LiWenhui2/RC-Car/cadence/controller/schematic/README.md

# 手持遥控器原理图

存放手持遥控器板的 OrCAD Capture 工程与原理图，主要包括 `.opj` 和 `.dsn` 文件。

内容覆盖 ESP32-C3、双轴摇杆、按键、状态指示、I2C 显示接口、USB及遥控器电源。
