LiWenhui2/RC-Car/cadence/vehicle/schematic/README.md

# 车辆控制板原理图

存放车辆控制板的 OrCAD Capture 工程与原理图，主要包括 `.opj` 和 `.dsn` 文件。

内容覆盖电池输入与保护、电源分配、ESP32-C3 SuperMini、TB6612FNG、电机接口、舵机接口及调试接口。
