LiWenhui2/RC-Car/cadence/controller/pcb/README.md

# 手持遥控器 PCB

存放手持遥控器板的 PCB 设计文件，主要文件类型为 `.brd`。

此处保留板框、布局、布线、约束和覆铜等可编辑设计；生产输出统一放入项目根目录的 `manufacturing`。
