LiWenhui2/RC-Car/cadence/vehicle/pcb/README.md

# 车辆控制板 PCB

存放车辆控制板的 PCB 设计文件，主要文件类型为 `.brd`。

此处保留板框、层叠、布局、布线、约束和覆铜等可编辑设计；Gerber 等生产文件应输出到项目根目录的 `manufacturing`。
