LiWenhui2/RC-Car/software/arduino/controller/README.md

# 遥控器正式固件

这里将保存 A 板的正式遥控器工程。接口保持输出标准化的 `throttle`、`steering`、`buttons` 和 `sequence`。
