LiWenhui2/RC-Car/agent.md

# RC-CAR 项目固定约束

本文件用于保存项目中已经确认的架构决定。后续建议、采购清单、PCB、机械结构和软件设计必须以本文件为准；除非用户明确修改，不得自行恢复为旧方案。

## 1. 当前版本决定

- 项目版本：`RC-CAR-V1.0`。
- 第一版车辆必须使用**舵机转向**，不使用左右轮差速完成转向。
- 第一版推荐机械结构：前轮转向机构 + 1 个 MG90S 舵机 + 后轮双电机驱动。
- 第一版油门命令同时作用于后左、后右电机；转向命令只转换为舵机角度。
- 第一版已验证 ESP-NOW、摇杆比例控制、100ms 失联停车和上电回中锁定；油门由摇杆直接控制，按键作为急停并触发重新回中解锁。车辆端采用加速每包80、减速每包200的油门斜坡，以及每10ms最多6μs的舵机平滑更新。
- 实车验证两只后轮电机的安装极性均与逻辑前进方向相反；车辆执行层固定使用 `MOTOR_A_DIRECTION=-1`、`MOTOR_B_DIRECTION=-1` 修正，通信层仍保持正油门代表前进。
- 第一版失联时：电机 PWM 清零、TB6612 STBY 拉低、舵机回中或保持已验证的安全中位。

## 2. 四轮差速扩展目标

- 后续版本允许改装为四个固定驱动轮的四轮差速结构。
- 扩展模式下，同一侧前后电机共用方向和 PWM 命令：
  - `left = throttle + steering`
  - `right = throttle - steering`
- 不要求四个车轮独立闭环控制；只要求左侧一组、右侧一组。
- 第一版购买的固定四TT电机4WD底盘不能直接作为舵机转向底盘；除非更换前桥机构，否则不得把它列为V1必买件。

## 3. 机械与安装孔预留

- V1底盘必须具有四个车轮、前轮转向节/拉杆和舵机安装位；后轮使用两个低电流TT减速电机或等效减速电机。
- 优先选择可拆卸前转向总成的底盘，使未来能换成固定前电机支架。
- 车体控制板目标外形不超过 `80mm × 60mm`。
- 控制板预留4个M3安装孔，建议孔径3.2mm、孔中心距约72mm × 52mm；最终尺寸必须在选定底盘实测后冻结。
- 底盘或转接板保留10mm孔距的M3孔阵列，并在前后各保留一组3.2mm宽长槽，便于在舵机前桥和固定电机支架之间改装。
- PCB天线端朝车体外侧，前方和下方保持净空，不得被电池、电机或金属铜柱遮挡。

## 4. 车体PCB固定接口

- 主控：ESP32-C3；原型阶段使用已经购买的 SuperMini 开发板，正式PCB使用ESP32-C3-MINI-1或预留SuperMini插座。
- 舵机接口：1个标准3针接口，定义为 `GND / SERVO_5V / SERVO_PWM`。
- 电机驱动：预留两组TB6612FNG模块插座或两颗驱动芯片位置：
  - Driver A：V1装配，控制后左、后右电机。
  - Driver B：V1可不装，未来控制前左、前右电机。
- 四个电机接口必须全部预留：`M_REAR_L`、`M_REAR_R`、`M_FRONT_L`、`M_FRONT_R`。
- Driver A与Driver B默认共享左右两组逻辑网络，使未来四轮差速不必增加大量GPIO：
  - `LEFT_IN1 / LEFT_IN2 / LEFT_PWM`
  - `RIGHT_IN1 / RIGHT_IN2 / RIGHT_PWM`
  - `MOTOR_STBY`
- 预留 `BAT_ADC`、I2C显示接口、BOOT/RESET、UART测试点和电源测试点。
- 在确认SuperMini实际引脚、启动绑带和USB占用之前，只冻结逻辑网络名，不提前冻结GPIO号码。

### 4.1 已选 ESP32-C3 开发板实物版本

- 遥控器板和车辆板当前选用同款 **DZQJ ESP32-C3 Mini/SuperMini 开发板**，不是裸 ESP32-C3-MINI-1 模组。
- 商品资料标注主芯片为 `ESP32-C3FN4`，板载 `4 MB Flash`，开发板标称外形为 `22.52 mm × 18 mm`。
- 开发板带 USB-C 接口、`BOOT` 按键和 `RESET` 按键；商品图显示左右各一排共两排引脚，计划在正式PCB上采用排针/排母插接方式，便于更换和调试。
- 当前实物的两排公排针已经整理并焊接为向下插接形式，可以直接插入标准面包板和2.54mm洞洞板。正式PCB应使用与之配套的两排通孔排母，不再把开发板本体直接焊死在主板上。
- 实物确认左右两排各有8根公排针，单排相邻引脚节距为2.54mm。插入2.54mm洞洞板后，左右两排针所在孔位连同两端自身共占7个孔位：两端之间有5个空孔，但7个孔中心形成6段间隔，因此两排中心距为 `6 × 2.54 mm = 15.24 mm`（600 mil）。
- 商品资料标注板载蓝色LED连接 `GPIO8`。设计时必须把它视为已有板载负载，不得默认GPIO8完全空闲。
- 商品说明称支持从外部 `5V` 与 `GND` 引脚供电，并明确提示外部供电与USB供电不可同时使用。车辆板必须避免USB 5V与外部5V电源硬并联。
- 进入下载模式时，商品说明给出的操作为：按住 `BOOT`，按下并松开 `RESET`，再松开 `BOOT`；必要时重复。
- 商品资料声称开发板支持3.3～6V供电，但本项目不依赖该宽范围宣传参数；车辆端仍按已验证的稳定5V输入方案设计，并核对实物板载稳压和5V引脚连接。
- PCB封装暂定名为 `ESP32_C3_DZQJ_SUPERMINI_SOCKET`，原理图符号暂定名为 `ESP32_C3_DZQJ_SUPERMINI`。
- 已确认每排8针、单排相邻引脚节距为2.54mm、两排中心距为15.24mm。开始制作 `.pad/.dra/.psm` 前，仍需核对并记录：方针尺寸、板边至首末孔中心距离、USB-C突出量、天线实际区域及装配总高度。
- 封装方向统一按元器件面顶视图描述，并在封装与符号对照表中明确USB端、天线端、左右两排每个焊盘的编号和实际丝印名称；不得仅凭网络上的其他SuperMini引脚图套用。

## 5. 电源固定规则

- 车体默认使用4节AA镍氢电池，标称约4.8V；不得将USB 5V与电池直接硬并联。
- 电源划分为：`VBAT_MOTOR`、`SERVO_5V`、`3V3_LOGIC`，三者共地但分支布线。
- 电机VM从电池经保险丝和反接保护供电。
- 当前V1已验证MG995可由4节AA镍氢电池的大电流分支直接供电；不得从ESP32的3.3V或5V脚给舵机供电。正式PCB仍需独立舵机电源分支和至少2A瞬态能力。
- ESP32逻辑使用独立3.3V稳压支路。
- 驱动入口预留470～1000µF电解电容；舵机5V入口预留1000µF电解电容；每个电机端子直接并联100nF陶瓷电容。
- 未来四电机扩展前必须实测单个电机的空载、启动和堵转电流，并重新核算电池、开关、线宽、连接器和驱动器余量。

## 5.1 遥控器PCB固定接口

- 遥控器板使用第二块ESP32-C3，连接双轴摇杆的两路ADC和按键输入。
- 预留0.96英寸I2C显示屏接口、状态LED、至少2个功能按键、BOOT/RESET和USB-C。
- 遥控器数据包只发送标准化的`throttle`与`steering`，不因车体采用舵机转向或四轮差速而更改硬件接口。
- 遥控器可先用USB供电；脱线运行时使用4节AAA镍氢电池和独立3.3V稳压，不得把电池与USB直接硬并联。

## 6. 软件架构固定规则

- 无线数据包和上层控制量不得绑定具体底盘结构；统一保留 `throttle`、`steering`、`buttons`、`sequence`。
- 执行层必须通过统一接口实现两种策略：
  - `ServoSteeringDrive`：两个后轮同速，`steering`映射为舵机角度。
  - `Differential4WD`：`steering`参与左右轮差速计算。
- 通过配置项选择 `SERVO_STEERING` 或 `DIFFERENTIAL_4WD`，通信层、失联保护和摇杆校准代码保持共用。
- 电机控制、舵机控制、无线通信、电池检测和安全状态机必须分模块实现。

## 7. 当前采购与验证状态

- 已购买并验证：ESP32-C3 SuperMini开发板×2、TB6612FNG、PS2双轴摇杆、四轮舵机转向底盘、MG995、4节AA镍氢电池及电池盒、面包板、导线和抗干扰电容。
- 已验证：两板ESP-NOW通信、100ms失联保护、双后轮正反转、MG995供电与脉宽控制。
- V1不应购买固定四TT电机的4WD差速底盘；应购买带前轮舵机转向机构的四轮底盘。
- V1最低需要1块TB6612FNG；PCB和线束必须为第2块TB6612FNG及前轮电机预留位置。

## 8. 建议的下一批材料

1. 四轮舵机转向底盘：前轮转向节/拉杆、后轮双电机、四个车轮、安装件。
2. MG995舵机×1（已购买并完成校准）。
3. TB6612FNG已焊排针模块×1；预算允许可一次购买2块，第二块用于扩展和备件。
4. PS2双轴10kΩ摇杆模块×1。
5. 4节AA电池盒、AA镍氢电池×4、对应充电器。
6. 5V/至少2A升降压模块×1，用于舵机支路；逻辑支路使用可靠3.3V稳压。
7. 100nF陶瓷电容至少4只、470～1000µF电解电容至少2只。
8. 电源开关、保险丝/自恢复保险丝、反接保护、22AWG电机线、连接器和热缩管。
