LiWenhui2/RC-Car/docs/RC-Car-V1_6x8洞洞板施工坐标表.md

# RC-Car V1 6×8cm洞洞板施工坐标表

板规格：80mm×60mm，2.54mm孔距，按31列×23行设计。列号从元件面左到右为1～31，行号从上到下为1～23。

## 元件坐标

| 器件 | 孔坐标/占用区 |
|---|---|
| JBAT 2P | (2,3)=GND；(4,3)=VBAT+ |
| 5V模块安装区 | 列14～30、行1～6；JREG位于(14,7)/(16,7)/(18,7)/(20,7) |
| ESP32-C3排母 | 左排列6、右排列12；行9～16，共2×8 |
| TB6612排母 | 左排列17、右排列23；行9～16，共2×8 |
| C1 1000μF | (25,9)=正；(25,11)=负 |
| C2 1000μF | (4,18)=正；(2,18)=负 |
| 后左电机端子 | (28,12)/(30,12) |
| 后右电机端子 | (28,16)/(30,16) |
| 舵机3P端子 | (2,21)=GND；(4,21)=VBAT；(6,21)=SIG |

## 为减少飞线采用的新车辆GPIO

| ESP32 | TB6612/舵机 |
|---|---|
| GPIO10 | PWMA |
| GPIO4 | AIN2 |
| GPIO3 | AIN1 |
| GPIO7 | STBY |
| GPIO6 | BIN1 |
| GPIO5 | BIN2 |
| GPIO20 | PWMB |
| GPIO21 | MG995信号 |

该映射与之前面包板程序不同。洞洞板焊好后必须使用配套的优化引脚程序，不能继续使用旧车辆端固件。

## 最少跳线

- 同排短直连4条：GPIO10-PWMA、GPIO7-STBY、GPIO6-BIN1、GPIO5-BIN2。
- 必要绝缘信号线4条：GPIO4-AIN2、GPIO3-AIN1、GPIO20-PWMB、GPIO21-SERVO。
- VBAT和GND各1条20AWG母线；电机输出使用20～22AWG短线。
- 100nF电容C3/C4直接焊在两只TT电机端子，不占洞洞板孔位。
