LiWenhui2/RC-Car/software/arduino/shared/README.md

# 公共协议与配置

这里将保存两端共享的通信数据结构、无线信道、失联保护参数和硬件无关控制接口。
