LiWenhui2/RC-Car/software/arduino/vehicle/README.md

# 车体正式固件

这里将保存 B 板的正式车体工程。V1 使用舵机转向和后轮双电机驱动，并保留四轮差速策略扩展。
