LiWenhui2/RC-Car/docs/diagrams/RC-Car-V1_6x8_真实元件面.png

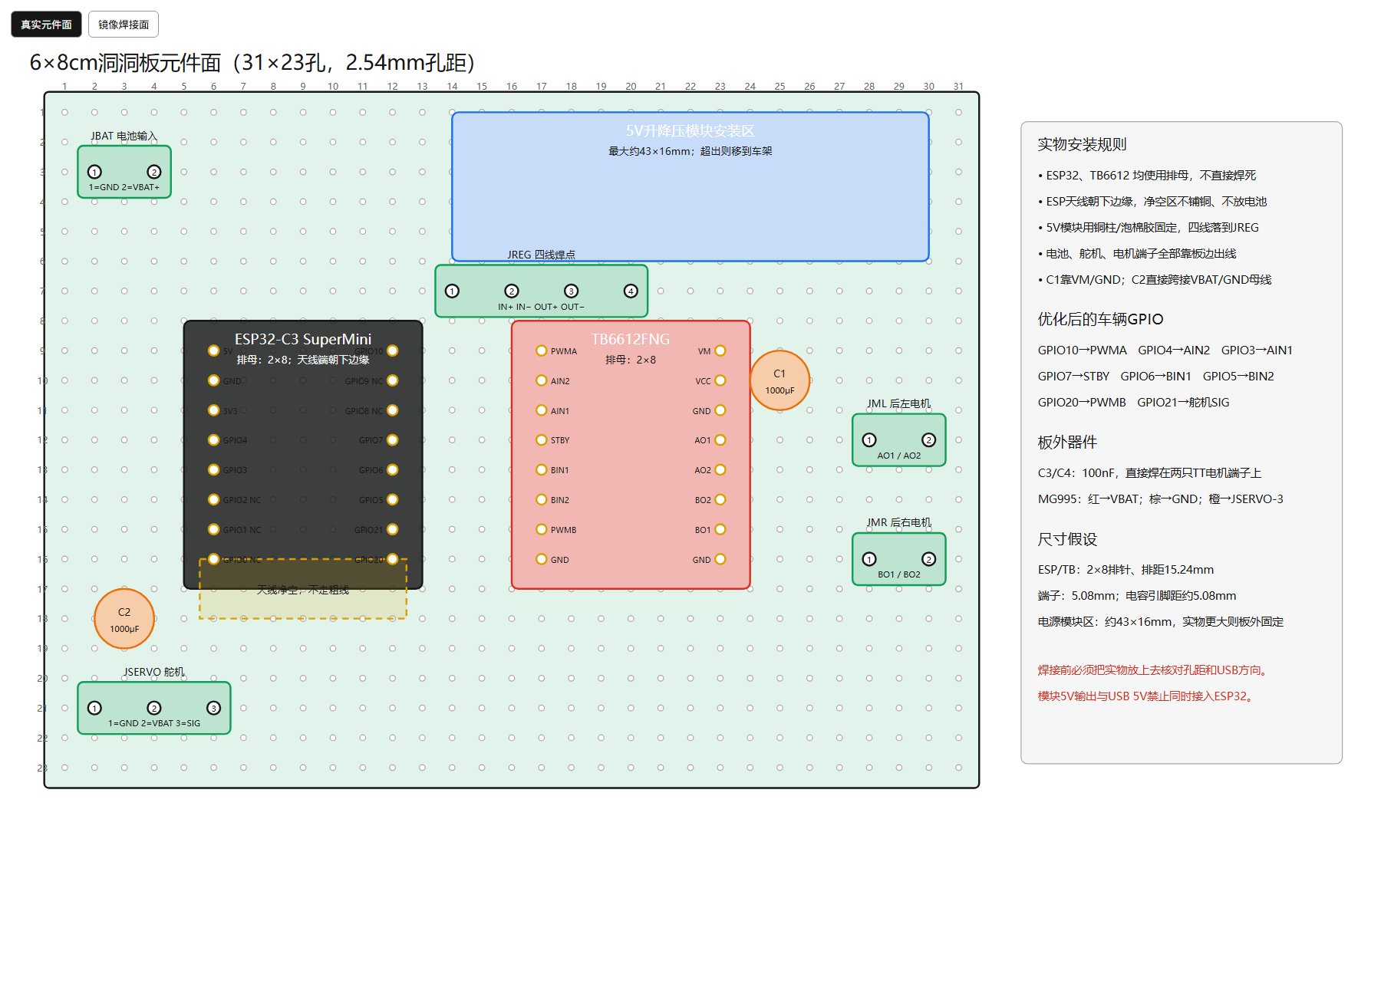
docs/diagrams/RC-Car-V1_6x8_真实元件面.png
