LiWenhui2/RC-Car/docs/diagrams/RC-Car-V1_6x8_镜像焊接面.png

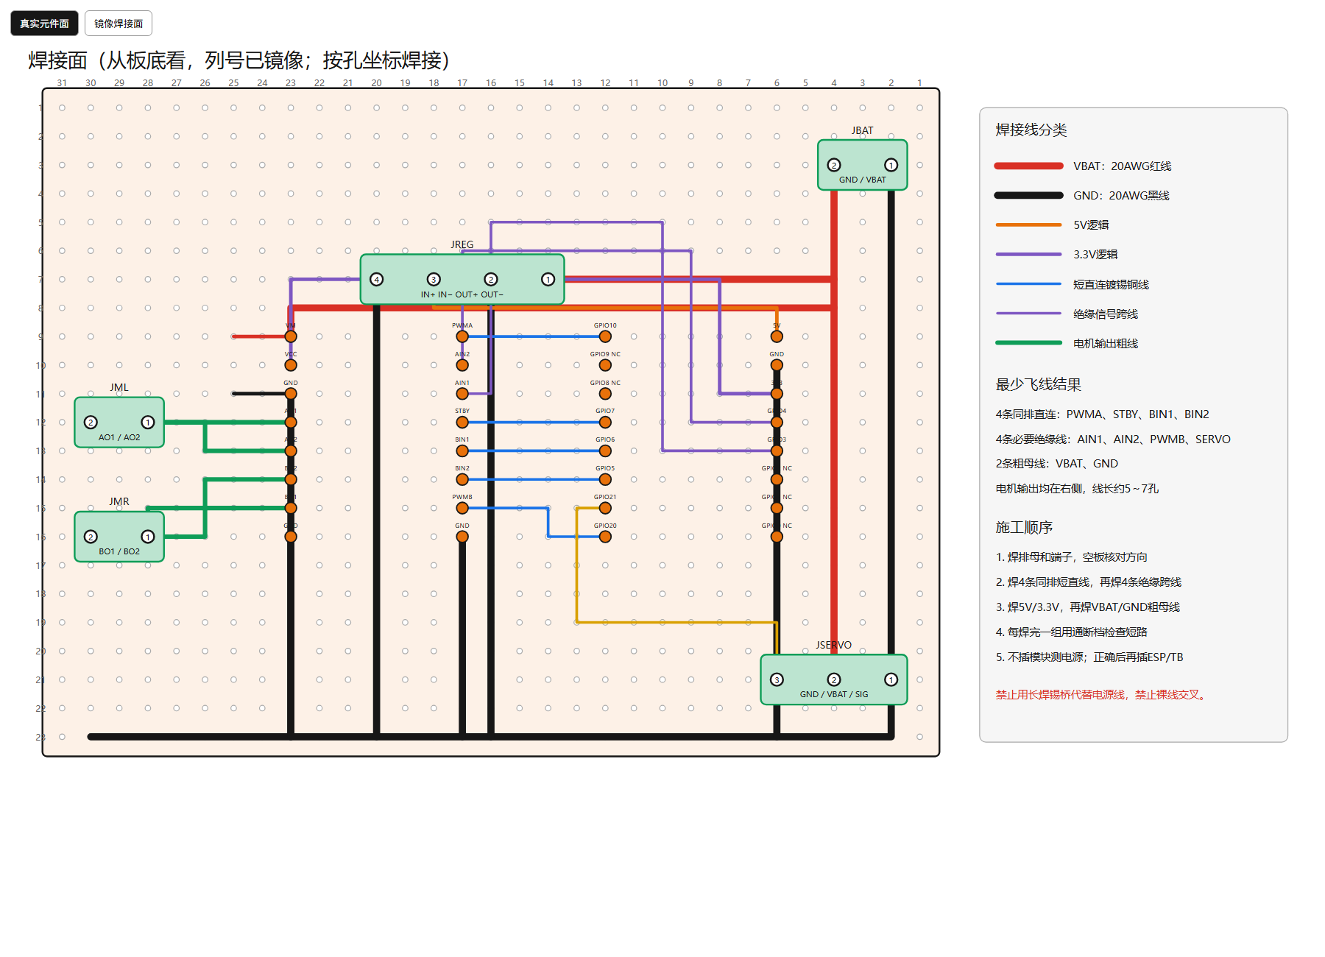
docs/diagrams/RC-Car-V1_6x8_镜像焊接面.png
