LiWenhui2/RC-Car/docs/diagrams/RC-Car-V1_洞洞板元件面.png

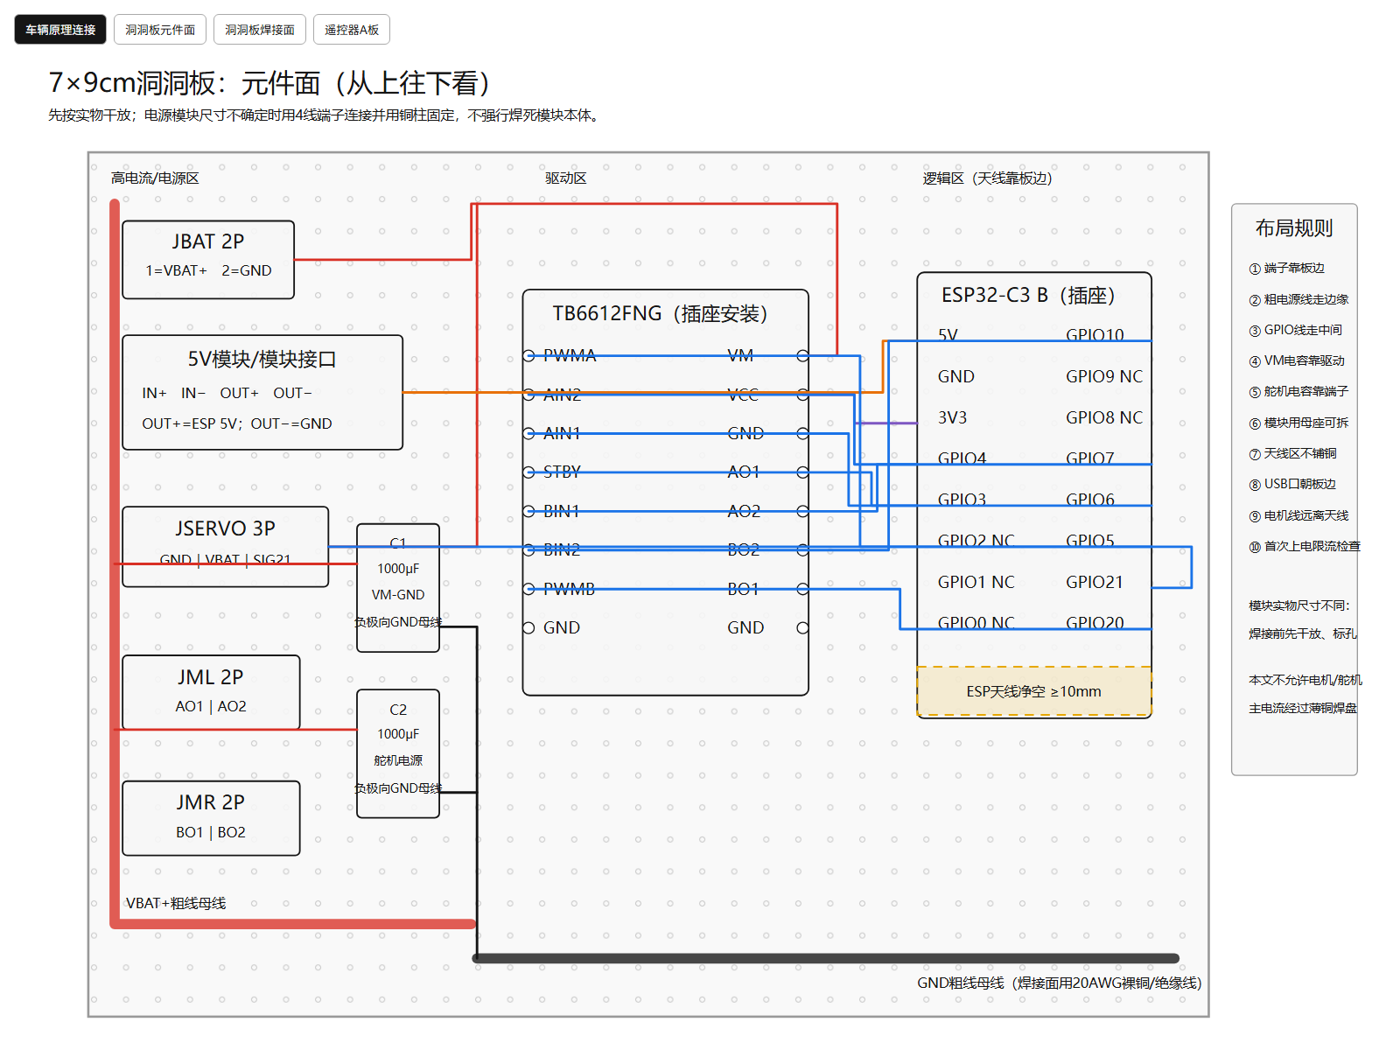
docs/diagrams/RC-Car-V1_洞洞板元件面.png
