LiWenhui2/RC-Car/docs/diagrams/RC-Car-V1_洞洞板焊接面.png

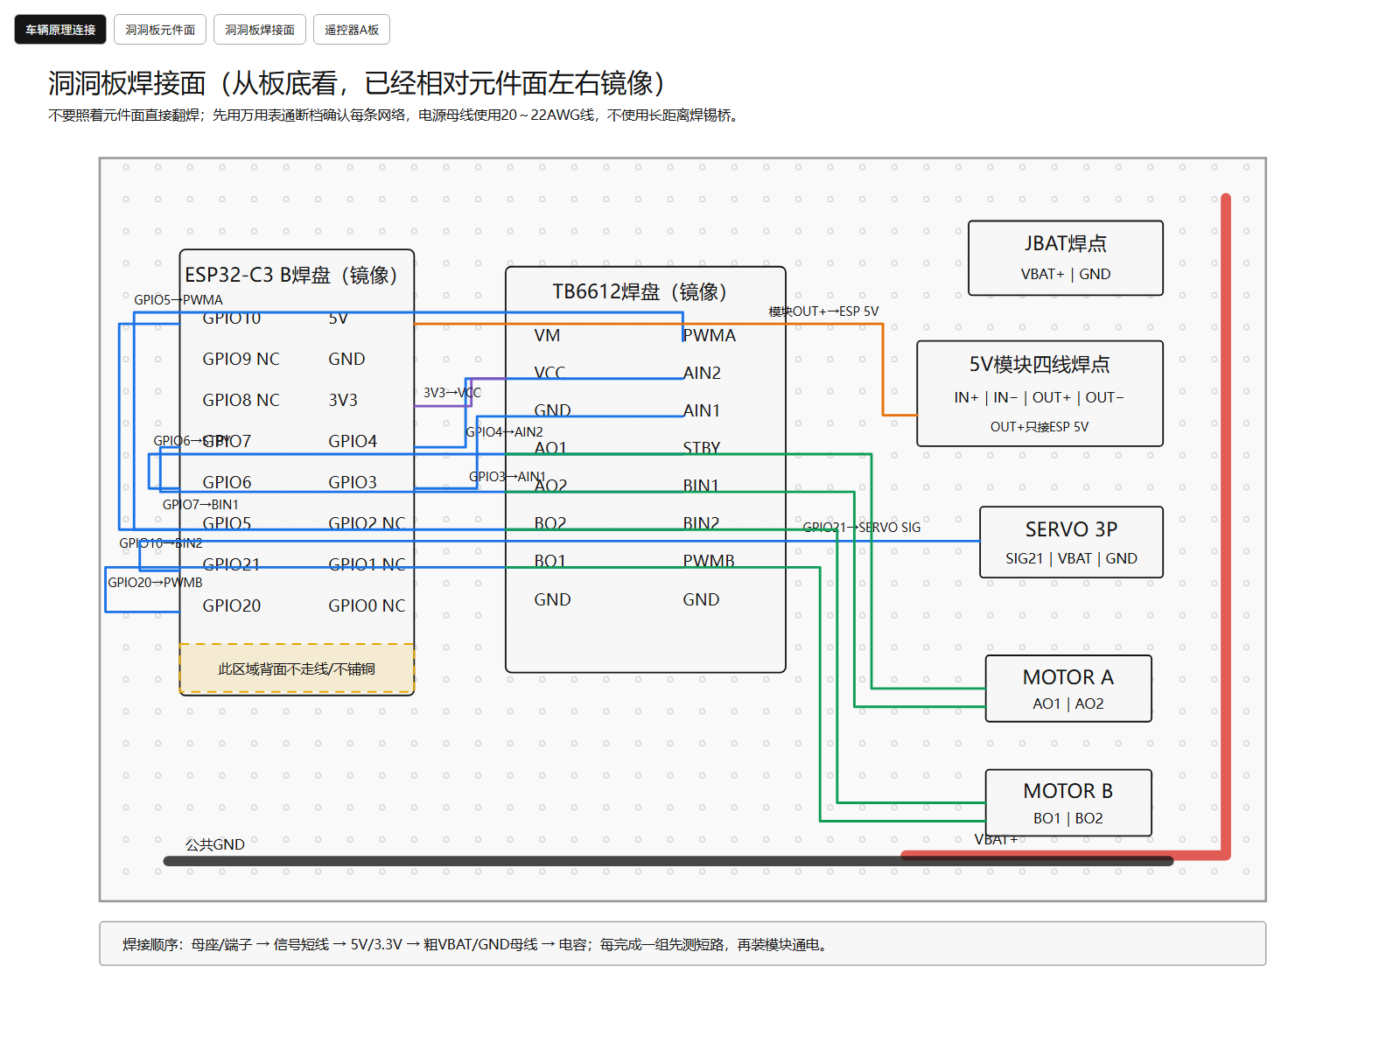
docs/diagrams/RC-Car-V1_洞洞板焊接面.png
