LiWenhui2/RC-Car/docs/diagrams/RC-Car-V1_车辆原理连接.png

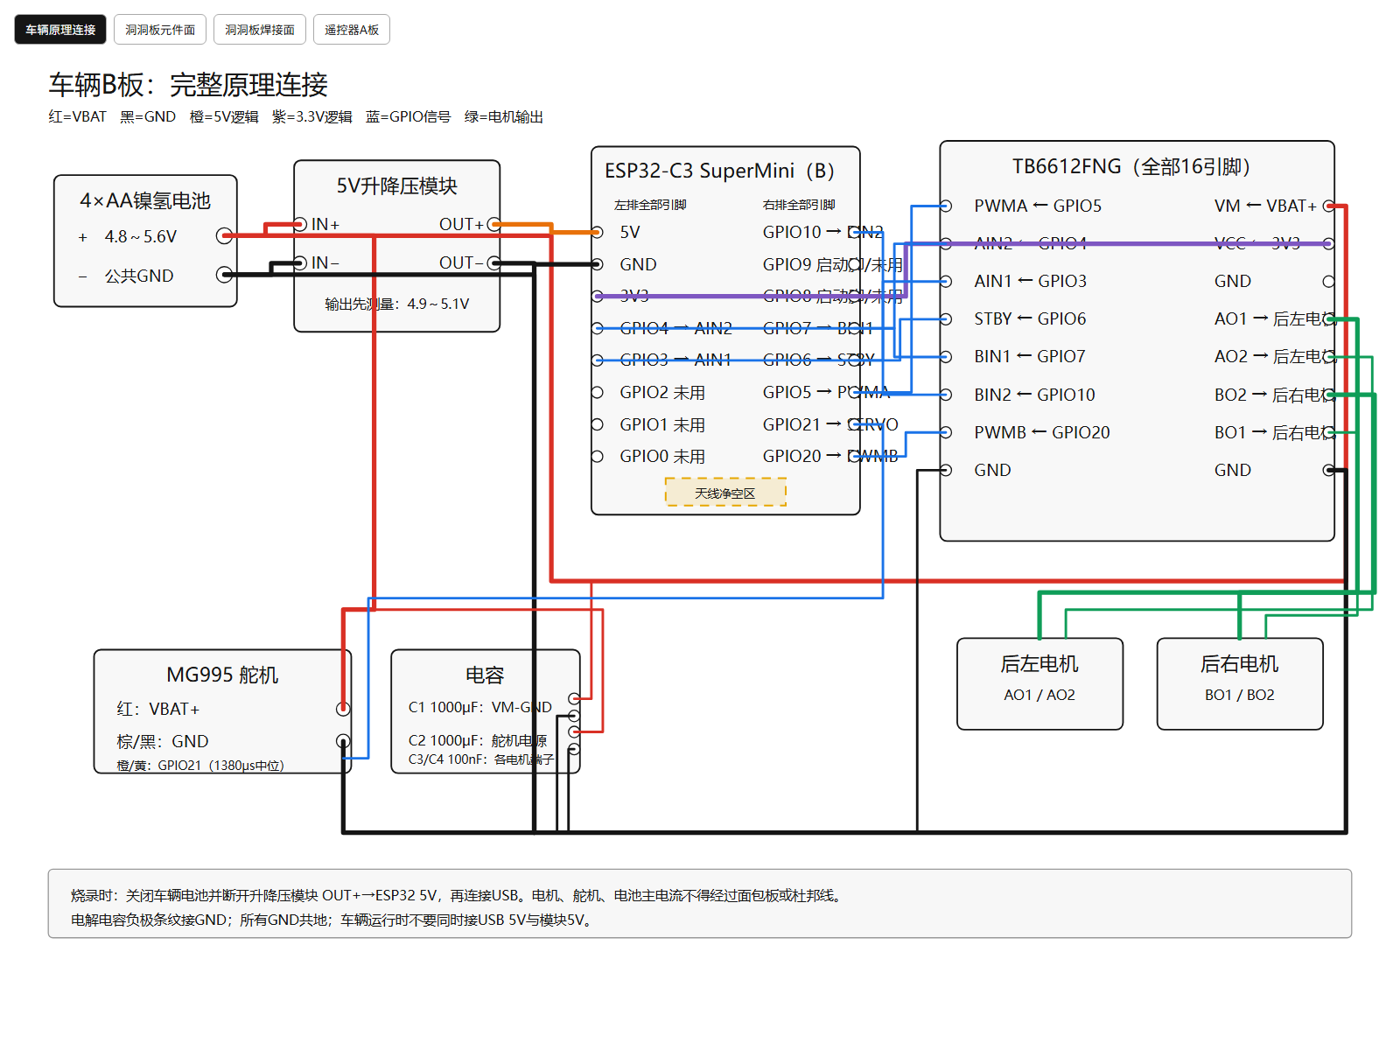
docs/diagrams/RC-Car-V1_车辆原理连接.png
