LiWenhui2/RC-Car/docs/diagrams/RC-Car-V1_遥控器接线.png

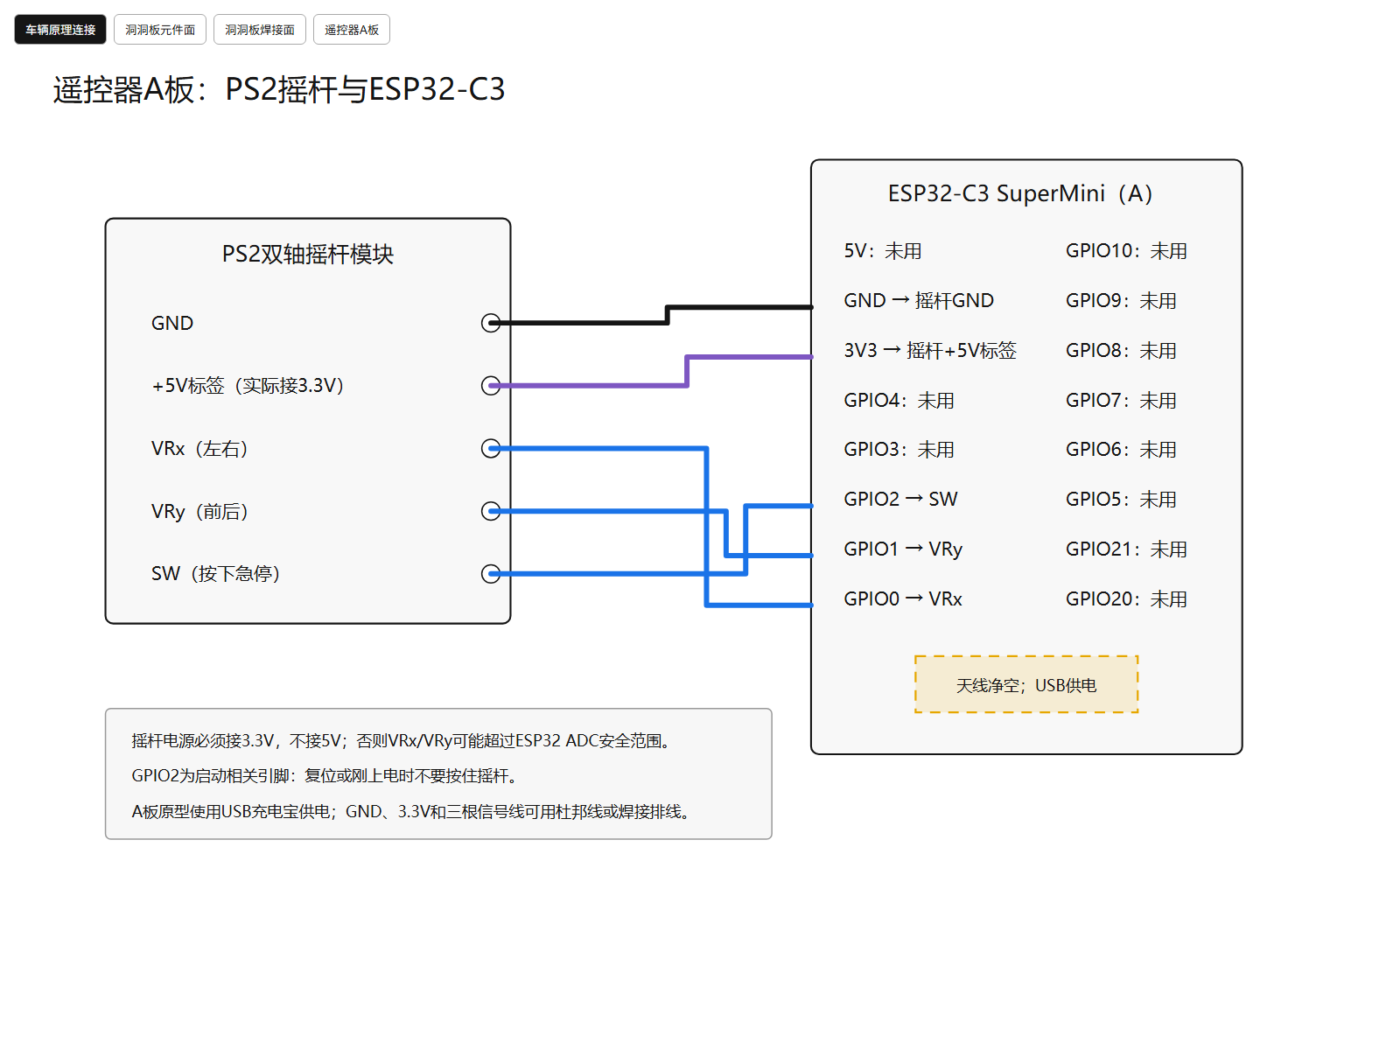
docs/diagrams/RC-Car-V1_遥控器接线.png
