LiWenhui2/RC-Car/outputs/01a0d97b-3272-7c23-ab1a-42ca7874a5cd/preview.png

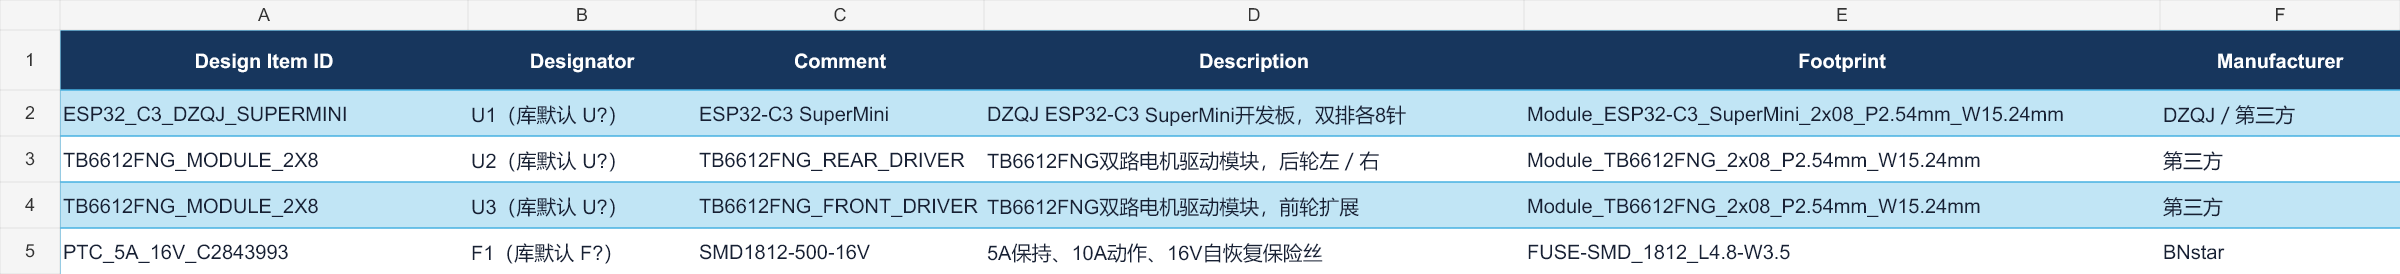
outputs/01a0d97b-3272-7c23-ab1a-42ca7874a5cd/preview.png
