LiWenhui2/RC-Car/outputs/ble-control/phone-launch.png

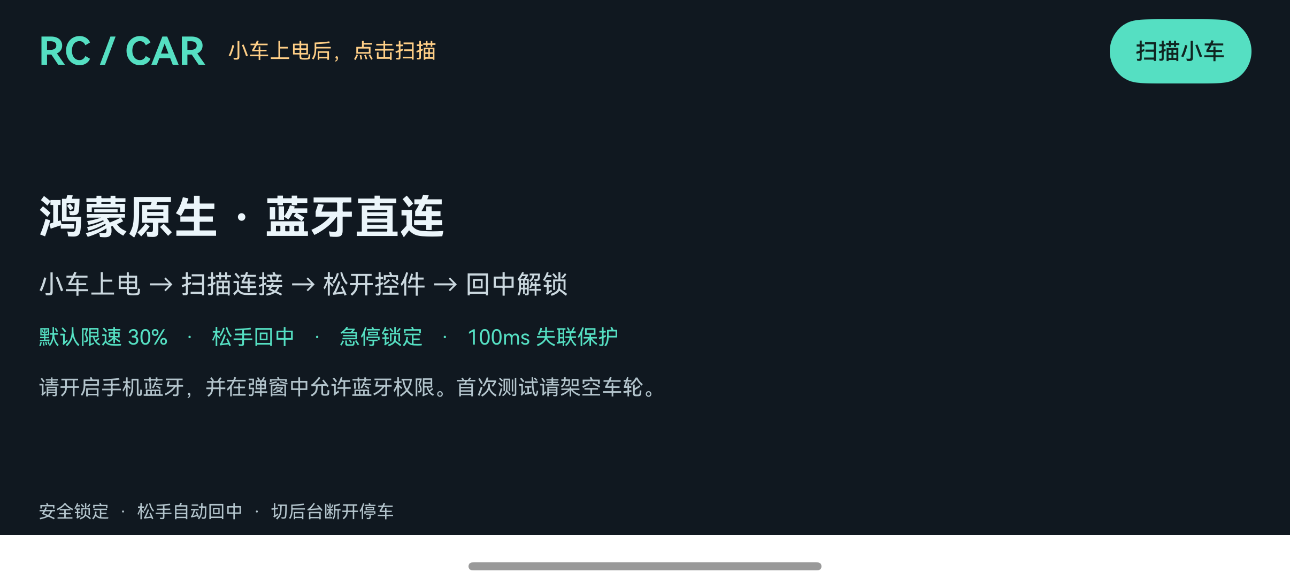
outputs/ble-control/phone-launch.png
