LiWenhui2/RC-Car/outputs/cadence_production_sop_20260921/render5/contacts/contact-01.jpg

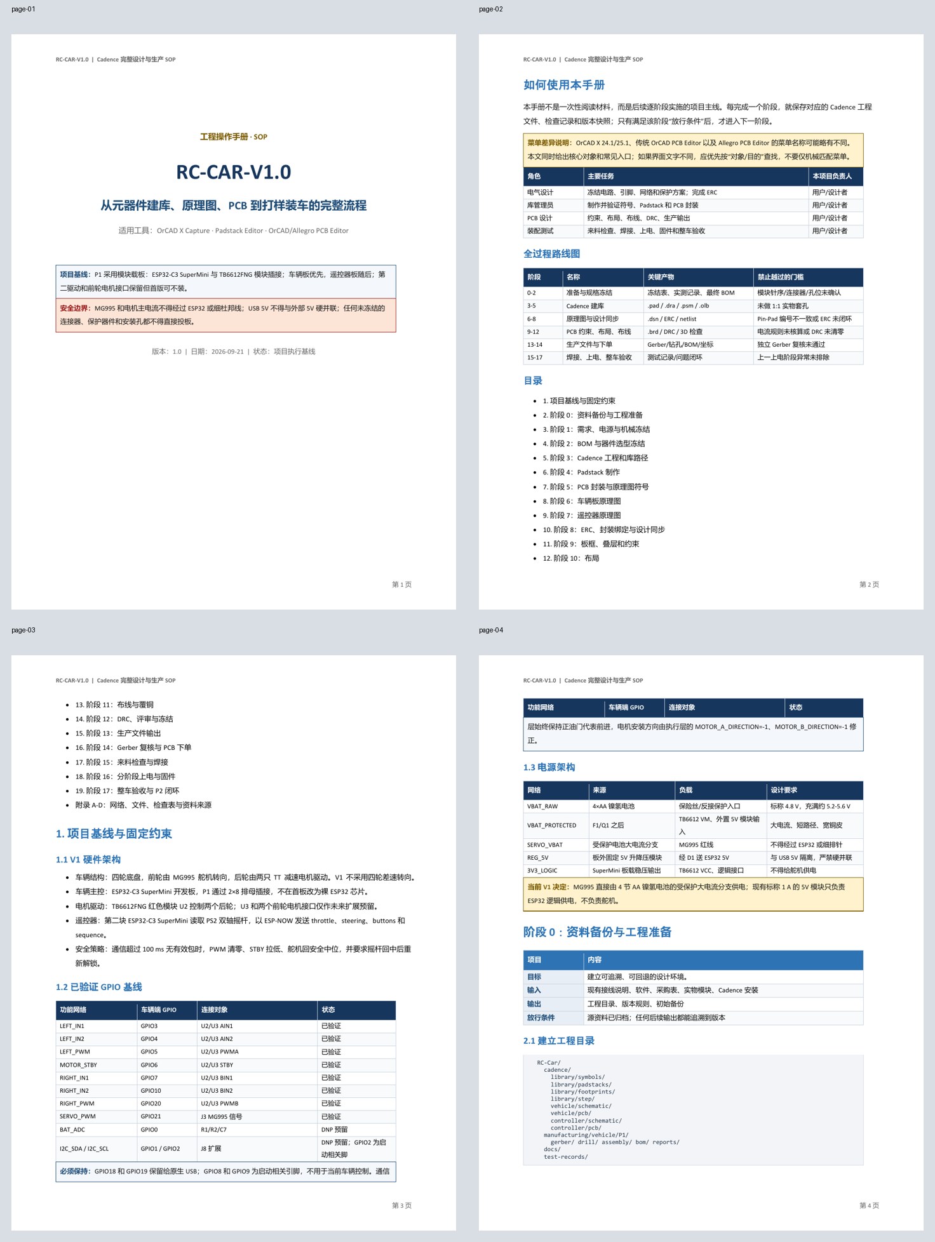
outputs/cadence_production_sop_20260921/render5/contacts/contact-01.jpg
