LiWenhui2/RC-Car/outputs/cadence_production_sop_20260921/render5/page-21.png

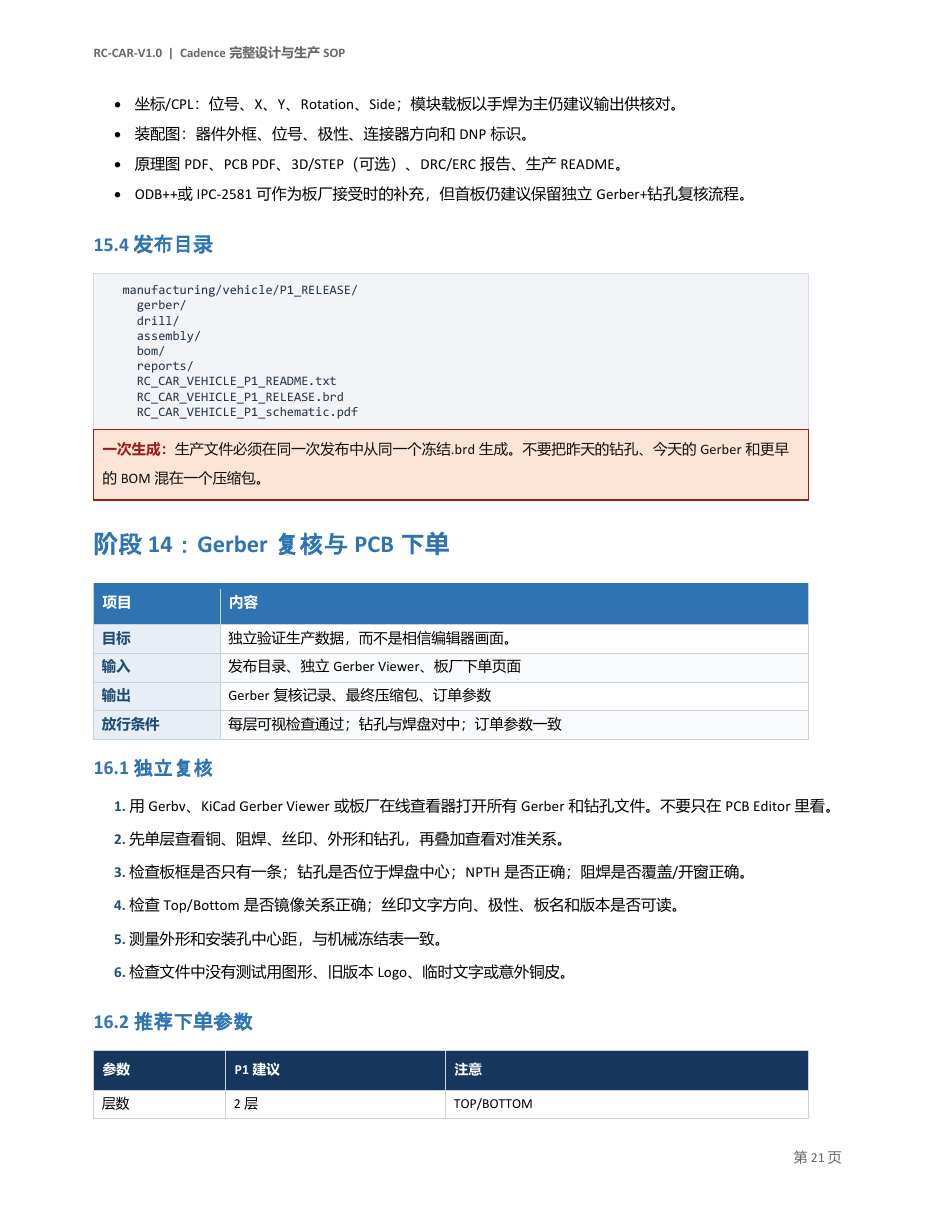
outputs/cadence_production_sop_20260921/render5/page-21.png
