LiWenhui2/RC-Car/outputs/rc_car_servo_v1_20260802/previews/架构总览.png

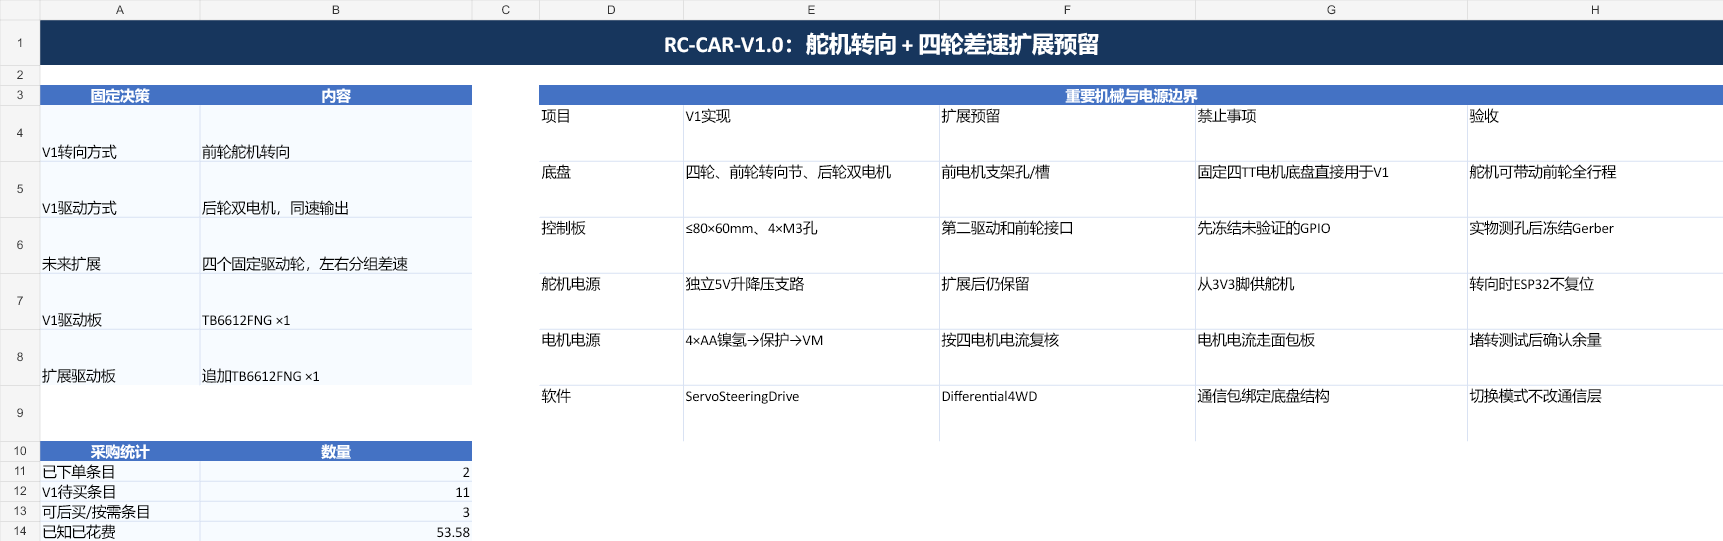
outputs/rc_car_servo_v1_20260802/previews/架构总览.png
