LiWenhui2/RC-Car/outputs/rc_car_servo_v1_20260802/previews/车体PCB规划.png

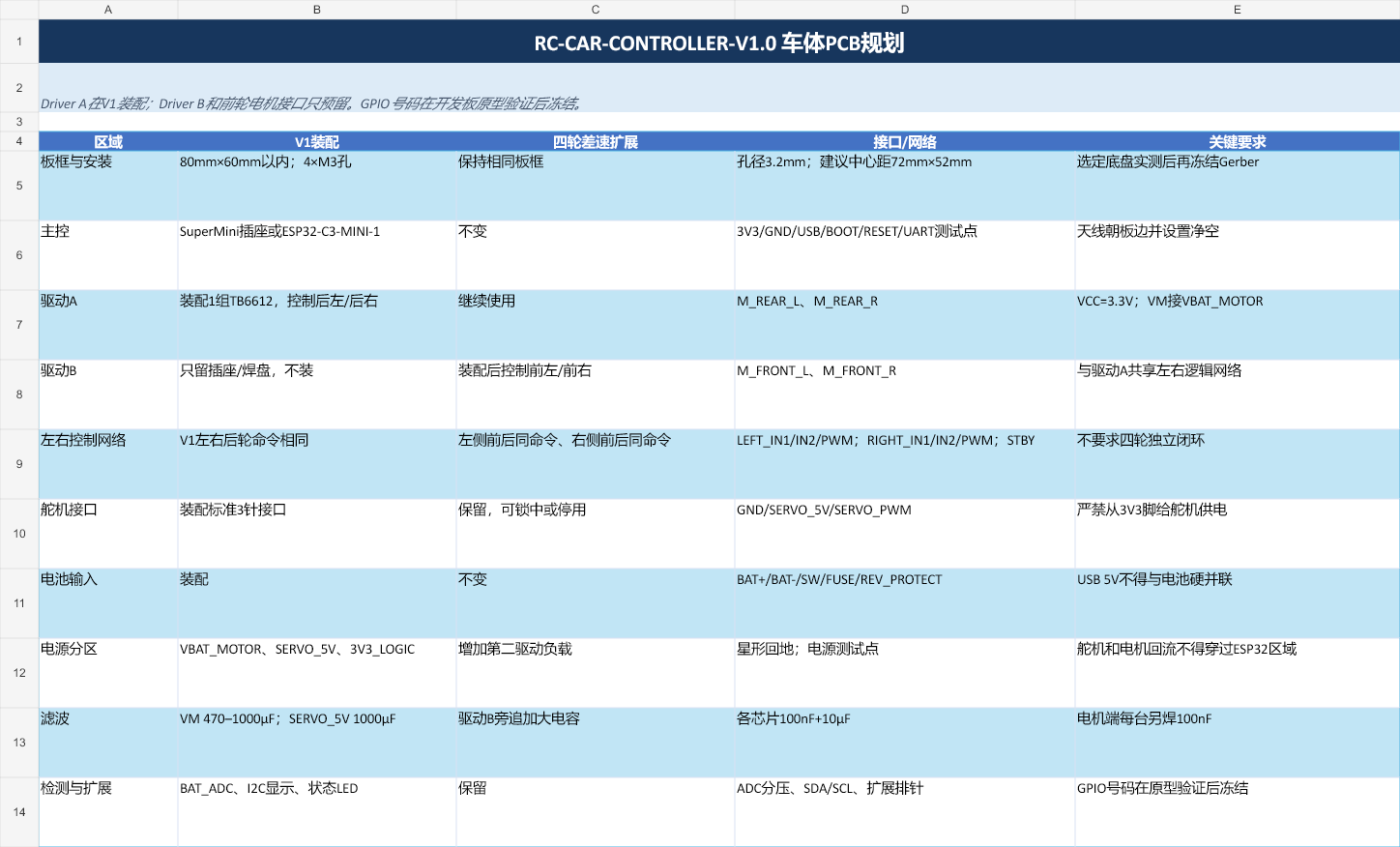
outputs/rc_car_servo_v1_20260802/previews/车体PCB规划.png
