LiWenhui2/RC-Car/outputs/rc_car_servo_v1_20260802/previews/遥控器PCB规划.png

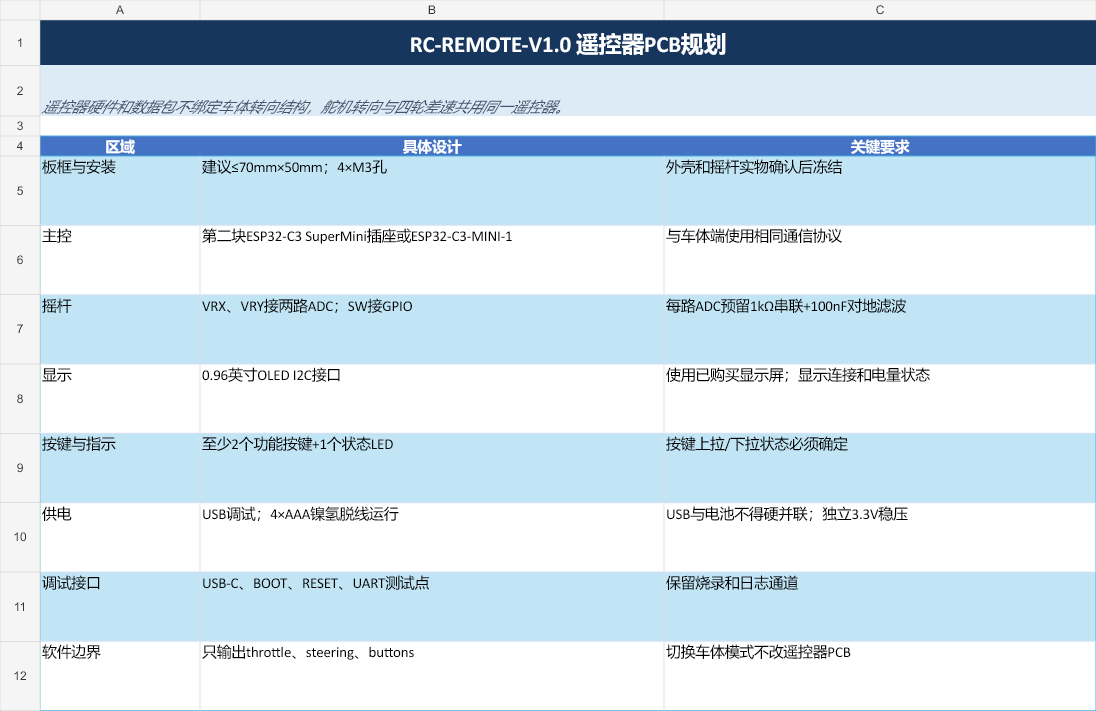
outputs/rc_car_servo_v1_20260802/previews/遥控器PCB规划.png
