LiWenhui2/RC-Car/manufacturing/bom/README.md

# 生产物料清单

存放与具体 PCB 版本对应的生产 BOM。至少记录位号、数量、器件规格、封装、制造商及制造商料号。
