LiWenhui2/RC-Car/outputs/rc_car_bom_20260802/RC-CAR-V1.0_器件采购清单.xlsx

Sheet: 采购总览
RC-CAR-V1.0 采购预算总览
项目 | 金额/数量 |  | 采购优先级 | 建议
当前必买预算 | ¥559.00 |  | 1 | 先购买首批原型必买项
如同时购买按需工具 | ¥1279.00 |  | 2 | 收到电机后实测空载及堵转电流
完整清单预算 | ¥1777.00 |  | 3 | 有线原型通过后再做无线
当前必买条目数 | 19 |  | 4 | 无线原型稳定后再买PCB物料
查询日期 | 2026-08-02 |  | 5 | 已有工具不要重复购买
 |  |  | 预算口径 | 当前必买预算不含工具、PCB物料及运费
类别 | 当前必买预算(元) | 条目数
原型电子 | ¥70.00 | 2
动力系统 | ¥99.00 | 2
机械结构 | ¥81.00 | 4
遥控输入 | ¥8.00 | 1
供电 | ¥203.00 | 5
原型连接 | ¥33.00 | 2
调试连接 | ¥30.00 | 1
抗干扰 | ¥5.00 | 1
线材固定 | ¥30.00 | 1
调试工具 | ¥0.00 | 0
焊接工具 | ¥0.00 | 0
焊接耗材 | ¥0.00 | 0
机械工具 | ¥0.00 | 0
PCB物料 | ¥0.00 | 0
PCB加工 | ¥0.00 | 0

Sheet: 器件清单
RC-CAR-V1.0 器件采购清单（价格查询日：2026-08-02）
说明：参考价为国内电商常见零售预算价，不含运费；链接优先使用搜索入口以降低失效风险，下单前请复核实时价格、规格和评价。
类别 | 器件名称 | 建议规格/型号 | 数量 | 单位 | 参考单价(元) | 是否计入当前预算 | 采购阶段 | 推荐平台 | 购买/搜索链接 | 小计(元) | 选型与验收要点 | 备注
原型电子 | ESP32-C3 开发板 | ESP32-C3 SuperMini，Type-C，4MB Flash，焊排针 | 2 | 块 | ¥25.00 | 是 | 首批必买 | 京东 | https://search.jd.com/Search | ¥50.00 | 不要误买普通 ESP32；确认可使用原生 USB/串口下载 | 建议同店同批次购买
原型电子 | TB6612FNG 双路电机驱动模块 | VM 2.5–13.5V，逻辑 3.3V 兼容，焊排针 | 2 | 块 | ¥10.00 | 是 | 首批必买 | 京东 | https://search.jd.com/Search | ¥20.00 | 实际使用1块，另1块备件；STBY 引脚必须接主控 | 先测电机堵转电流
动力系统 | N20 6V 金属减速电机 | 6V，建议 100–300rpm，D形轴；堵转电流目标≤1A | 3 | 个 | ¥25.00 | 是 | 首批必买 | 淘宝 | https://s.taobao.com/search | ¥75.00 | 实际使用2个，备1个；优先购买带参数曲线产品 | 必须与轮毂、支架轴径匹配
动力系统 | N20 匹配轮胎 | 轮径55–70mm，轮毂与电机D轴匹配 | 2 | 个 | ¥12.00 | 是 | 首批必买 | 淘宝 | https://s.taobao.com/search?q=N20%20D%E8%BD%B4%20%E8%BD%AE%E8%83%8E%2065mm | ¥24.00 | 确认轴孔形状、孔径及紧固方式 | 建议和电机同店购买
机械结构 | N20 电机安装支架 | 金属或3D打印支架，孔位匹配底盘 | 2 | 个 | ¥8.00 | 是 | 首批必买 | 淘宝 | https://s.taobao.com/search | ¥16.00 | 确认含螺丝及安装孔尺寸 | 建议和电机同店购买
机械结构 | 万向轮 | 20–30mm 小型万向轮，带安装螺丝 | 1 | 个 | ¥10.00 | 是 | 首批必买 | 京东 | https://search.jd.com/Search | ¥10.00 | 安装高度要与驱动轮轴线和底盘匹配 | 可用尼龙柱调高度
机械结构 | 底盘板 | 约160×120mm，亚克力/铝板/可打孔板 | 1 | 块 | ¥30.00 | 是 | 首批必买 | 淘宝 | https://s.taobao.com/search | ¥30.00 | 先画布局再打孔；轮胎不可摩擦底盘 | 也可自行切割
遥控输入 | 双轴模拟摇杆模块 | PS2款，10kΩ，X/Y模拟输出+按压开关 | 1 | 个 | ¥8.00 | 是 | 首批必买 | 京东 | https://search.jd.com/Search | ¥8.00 | 供电使用3.3V，避免ADC超过主控电压 | 中心值需软件校准
供电 | 4×AA 带开关电池盒 | 串联，带引线或DC插头 | 1 | 个 | ¥8.00 | 是 | 首批必买 | 京东 | https://search.jd.com/Search | ¥8.00 | 车体使用；确认不是并联盒 | 建议选粗导线款
供电 | 4×AAA 带开关电池盒 | 串联，带引线 | 1 | 个 | ¥7.00 | 是 | 首批必买 | 京东 | https://search.jd.com/Search | ¥7.00 | 遥控器使用；确认外形能装入外壳
供电 | AA 镍氢充电电池 | 1.2V，1900–2500mAh，低自放电 | 4 | 节 | ¥15.00 | 是 | 首批必买 | 京东 | https://search.jd.com/Search | ¥60.00 | 同品牌同容量同批次成组使用 | 不要混用新旧电池
供电 | AAA 镍氢充电电池 | 1.2V，750–1000mAh，低自放电 | 4 | 节 | ¥12.00 | 是 | 首批必买 | 京东 | https://search.jd.com/Search | ¥48.00 | 同品牌同容量同批次成组使用
供电 | 智能镍氢充电器 | 独立槽，支持AA/AAA，满充断电 | 1 | 台 | ¥80.00 | 是 | 首批必买 | 京东 | https://search.jd.com/Search | ¥80.00 | 不要使用无独立检测的廉价定时充电器 | 已有兼容充电器可不买
原型连接 | 830孔面包板 | 标准830孔，接触可靠 | 1 | 块 | ¥15.00 | 是 | 首批必买 | 京东 | https://search.jd.com/Search?keyword=830%E5%AD%94%20%E9%9D%A2%E5%8C%85%E6%9D%BF | ¥15.00 | 电机大电流不要经过面包板电源轨 | 仅用于逻辑信号
原型连接 | 杜邦线套装 | 公对公/公对母/母对母，各20cm | 1 | 套 | ¥18.00 | 是 | 首批必买 | 京东 | https://search.jd.com/Search | ¥18.00 | 电机与电池回路改用更粗导线
调试连接 | USB-C 数据线 | 明确支持数据传输，0.5–1m | 2 | 条 | ¥15.00 | 是 | 首批必买 | 京东 | https://search.jd.com/Search | ¥30.00 | 部分充电线没有数据功能 | 两块开发板各一条
抗干扰 | 100nF 陶瓷电容 | 独石/瓷片，50V；直接焊在电机两端 | 10 | 个 | ¥0.50 | 是 | 首批必买 | 淘宝 | https://s.taobao.com/search?q=100nF%20104%2050V%20%E9%99%B6%E7%93%B7%E7%94%B5%E5%AE%B9 | ¥5.00 | 每台电机至少1个，其余备用 | 引脚越短越好
线材固定 | 硅胶线+热缩管+扎带 | 22–26AWG多色线，热缩管组合 | 1 | 套 | ¥30.00 | 是 | 首批必买 | 京东 | https://search.jd.com/Search | ¥30.00 | 电池和电机线不要使用细杜邦线
机械结构 | M3螺丝/螺母/尼龙柱套装 | M3多长度，含铜柱或尼龙柱 | 1 | 套 | ¥25.00 | 是 | 首批必买 | 京东 | https://search.jd.com/Search | ¥25.00 | 用于PCB、电池盒和底盘固定
调试工具 | 可调直流稳压电源 | 0–30V、0–5A，必须支持恒流限流 | 1 | 台 | ¥300.00 | 按需 | 强烈建议 | 京东 | https://search.jd.com/Search | ¥0.00 | 测空载/启动/堵转电流及安全上电的关键工具 | 已有则不重复购买
调试工具 | 数字万用表 | 具备直流电压、电阻、通断及至少10A电流档 | 1 | 台 | ¥120.00 | 按需 | 强烈建议 | 京东 | https://search.jd.com/Search | ¥0.00 | 测电机电流时注意表笔插孔和量程 | 已有合格设备可不买
焊接工具 | 恒温焊台 | 60W以上，可调温，常用烙铁头可替换 | 1 | 台 | ¥180.00 | 按需 | PCB阶段必需 | 京东 | https://search.jd.com/Search | ¥0.00 | PCB阶段必需；初期模块接线也会用到 | 已有则不买
焊接耗材 | 焊锡丝/助焊剂/吸锡带 | 0.5–0.8mm焊锡丝，电子助焊剂 | 1 | 套 | ¥50.00 | 按需 | PCB阶段必需 | 京东 | https://search.jd.com/Search | ¥0.00 | 注意通风，焊后清洁助焊剂残留
调试工具 | USB逻辑分析仪 | 8通道24MHz，支持3.3V信号 | 1 | 个 | ¥45.00 | 否 | 可选调试 | 淘宝 | https://s.taobao.com/search | ¥0.00 | 用于分析控制周期和通信时序，不是首批刚需
调试工具 | 非接触测温仪 | -50–380℃常见型号 | 1 | 个 | ¥70.00 | 否 | 可选调试 | 京东 | https://search.jd.com/Search | ¥0.00 | 便于记录驱动芯片、电机及接插件温升 | 可用热电偶温度计替代
机械工具 | 数字游标卡尺 | 0–150mm，分辨率0.01mm | 1 | 把 | ¥70.00 | 按需 | 机械阶段建议 | 京东 | https://search.jd.com/Search | ¥0.00 | 核对轴径、孔距和外壳尺寸 | 已有则不买
PCB物料 | ESP32-C3-MINI-1 模组 | 原装模组，4MB Flash，封装资料齐全 | 4 | 个 | ¥25.00 | 否 | 原型通过后 | 京东 | https://search.jd.com/Search?keyword=ESP32-C3-MINI-1%20%E6%A8%A1%E7%BB%84%20%E5%8E%9F%E8%A3%85 | ¥0.00 | 两块PCB各1个，余量用于焊接损耗/备件 | 不要在原型通过前大量采购
PCB物料 | TB6612FNG 芯片 | SSOP-24，正规渠道 | 3 | 个 | ¥12.00 | 否 | 原型通过后 | 淘宝 | https://s.taobao.com/search?q=TB6612FNG%20%E5%8E%9F%E8%A3%85%20SSOP24 | ¥0.00 | 车体板1个，其余备件；注意假货和丝印
PCB物料 | 3.3V稳压器及外围 | 建议≥600mA，低压差；型号在原理图阶段冻结 | 4 | 套 | ¥8.00 | 否 | 原型通过后 | 淘宝 | https://s.taobao.com/search | ¥0.00 | 必须根据4节镍氢最高电压、压差和ESP32峰值电流复核 | 先定型号再定封装
PCB物料 | USB-C 16P母座 | USB2.0贴片，带定位柱 | 5 | 个 | ¥3.00 | 否 | 原型通过后 | 淘宝 | https://s.taobao.com/search?q=USB%20Type-C%2016P%20%E6%AF%8D%E5%BA%A7%20USB2.0%20%E8%B4%B4%E7%89%87 | ¥0.00 | 封装必须与实物完全一致 | 购买后实测封装再画板
PCB物料 | PCB通用阻容/LED/按键/保护器件 | 100nF、10uF、470uF、5.1k、分压、LED、按键、保险丝等 | 1 | 批 | ¥100.00 | 否 | 原型通过后 | 淘宝 | https://s.taobao.com/search | ¥0.00 | 最终数量以原理图BOM为准，此行为预留预算 | 不建议用不明品牌电解电容
PCB加工 | 双层PCB打样 | 车体板+遥控器板，各5片，1.6mm/1oz | 1 | 批 | ¥100.00 | 否 | 原型通过后 | 其他 | https://www.jlc.com/ | ¥0.00 | 价格受尺寸、运费、表面工艺和优惠影响 | 下单前完成ERC/DRC/Gerber检查
当前必买预算合计（不含“按需”和“否”） |  |  |  |  |  |  |  |  |  | ¥559.00 | 实际支出请将是否计入预算改为“是”并更新单价

Sheet: 选型与采购说明
选型、下单与验收说明
主题 | 建议 | 原因/风险
采购顺序 | 先买开发板、驱动模块、电机/轮胎/支架、供电、摇杆和原型连接材料。 | 电机参数和机械尺寸会决定驱动器及PCB设计。
电机选择 | 首选6V N20金属减速电机，100–300rpm；购买3个并挑选匹配的2个。 | 需要实测空载电流、启动电流和≤1秒堵转电流；目标堵转≤1A/个。
传动匹配 | 电机、轮胎和支架尽量同店购买；核对轴径、D轴形状、轮毂孔及支架孔距。 | 规格不匹配是新手项目最常见的机械返工来源。
供电安全 | 车体先用4节AA镍氢；禁止USB 5V与电池直接并联。 | 电机启动压降可能导致ESP32复位，后续PCB需分支滤波。
TB6612适用条件 | 只有在单电机实测堵转电流接近或低于1A时继续使用。 | 超过能力会导致芯片过热、限流或损坏，应更换更强驱动。
电商链接 | 清单使用平台搜索链接；下单时比较近期评价、实拍、规格表和退换政策。 | 单品详情页和价格变化快，搜索入口更耐用。
预算使用 | “是否计入当前预算”可改为是/按需/否；小计和总览会自动更新。 | 已有工具可标记为否，实际单价可直接覆盖参考单价。
到货验收 | 核对型号数量；万用表测短路；开发板先跑LED；电机逐个限流测试并记录。 | 不要把所有器件一次接上电，便于隔离故障。
价格声明 | 参考价为2026-08-02常见零售预算值，不代表指定商家承诺价，且未计运费。 | 促销、地区、店铺、包装数量和开票要求都会改变价格。
