LiWenhui2/RC-Car/outputs/rc_car_bom_20260802/RC-CAR-V1.0_器件采购清单_具体商品链接版.xlsx

Sheet: 采购总览
RC-CAR-V1.0 采购预算总览
项目 | 金额/数量 |  | 采购优先级 | 建议
当前必买预算 | ¥347.70 |  | 1 | 先购买首批原型必买项
如同时购买按需工具 | ¥1095.70 |  | 2 | 收到电机后实测空载及堵转电流
完整清单预算 | ¥1095.70 |  | 3 | 有线原型通过后再做无线
当前必买条目数 | 9 |  | 4 | 无线原型稳定后再买PCB物料
查询日期 | 2026-08-02 |  | 5 | 已有工具不要重复购买
 |  |  | 预算口径 | 当前必买预算不含工具、PCB物料及运费
类别 | 当前必买预算(元) | 条目数
原型电子 | ¥87.00 | 2
机械动力 | ¥59.00 | 1
遥控输入 | ¥18.00 | 1
原型连接 | ¥69.00 | 1
调试连接 | ¥39.90 | 1
供电 | ¥59.80 | 2
抗干扰 | ¥15.00 | 1
调试工具 | ¥0.00 | 0
焊接工具 | ¥0.00 | 0

Sheet: 器件清单
RC-CAR-V1.0 已选商品采购清单（具体商品链接版，2026-08-02）
说明：本表链接均为已经选定的商品详情页，不再使用搜索页。进入详情页后仍须按“具体规格”列选择对应SKU；价格为预算值，不含运费，以结算页为准。
类别 | 已选商品 | 下单时选择的具体规格 | 数量 | 单位 | 参考单价(元) | 是否计入当前预算 | 采购阶段 | 平台 | 商品详情直达链接 | 小计(元) | 下单与验收要点 | 备注
原型电子 | 凯元达 ESP32-C3 SuperMini 开发板 | 已焊排针；商品页需选“已焊接排针” | 2 | 块 | ¥29.00 | 是 | 首批必买 | 京东 | https://item.jd.com/100124881482.html | ¥58.00 | 确认选项是 ESP32-C3 SuperMini 已焊排针，不是裸模组或未焊版本 | 遥控器、车体各一块
原型电子 | 轮趣 TB6612FNG 双路驱动模块 | 双路 TB6612，焊接排针版本 | 1 | 块 | ¥29.00 | 是 | 首批必买 | 京东 | https://item.jd.com/10162327051022.html | ¥29.00 | 选择“焊接排针 双路TB6612”；逻辑电平须兼容3.3V | 电机堵转电流实测后再确认长期适用性
机械动力 | 登仕唐 2WD 智能小车底盘套件 | 商品页选择“2WD迷你全套” | 1 | 套 | ¥59.00 | 是 | 首批必买 | 京东 | https://ic-item.jd.com/10095736668343.html | ¥59.00 | 该套装一次解决底盘、两台TT电机、轮胎、万向轮、安装件和电池盒匹配问题 | 首版原型采用TT电机，降低机械选型风险
遥控输入 | 登仕唐 PS2 双轴摇杆模块 | 红板防反插接口，配5P线 | 1 | 个 | ¥18.00 | 是 | 首批必买 | 京东 | https://item.jd.com/10207428429840.html | ¥18.00 | 商品页选择“红板防反插接口 配5P线”；使用3.3V供电 | 中心值需要软件校准及死区
原型连接 | DZQJ MB-102 面包板基础实验套件 | 830孔面包板、杜邦线及常用原型配件 | 1 | 套 | ¥69.00 | 是 | 首批必买 | 京东 | https://item.jd.com/10145422358367.html | ¥69.00 | 选择“面包板套件基础电子实验”；确认包含公对公/公对母线 | 电机与电池大电流不得经过面包板电源轨
调试连接 | 绿联 30875 二合一数据线2条装 | USB-A 转 Micro USB/Type-C，1m，2条装 | 1 | 套 | ¥39.90 | 是 | 首批必买 | 京东 | https://item.jd.com/100061434896.html | ¥39.90 | 页面明确为数据线且含Type-C接头；一套两条 | 两块开发板可同时连接电脑
供电 | 松下 AA 5号碱性电池 | 商品页选择5号规格，至少4节 | 1 | 组 | ¥29.90 | 是 | 首批必买 | 京东 | https://item.jd.com/10141652671465.html | ¥29.90 | 首轮调试先用正规碱性电池；不要混用新旧电池 | 后续确认续航后再升级低自放电镍氢
供电 | 松下 AAA 7号碱性电池 | 商品页选择7号4节 | 1 | 组 | ¥29.90 | 是 | 首批必买 | 京东 | https://item.jd.com/10141652671465.html | ¥29.90 | 用于遥控器；下单前确认选项显示“7号4节” | 若底盘套装不含遥控器电池盒，先USB供电调试遥控端
抗干扰 | 104 100nF 50V 陶瓷电容100只 | 引脚间距5mm，100nF/0.1uF，50V | 1 | 包 | ¥15.00 | 是 | 首批必买 | AliExpress | https://www.aliexpress.com/item/32375639403.html | ¥15.00 | 每台电机两端焊1只，引脚尽量短；到货抽测容量 | 页面币种可能自动切换
调试工具 | 兆信 KXB-325DW 可调直流稳压电源 | 0–30V级，恒压/恒流，含输出线 | 1 | 台 | ¥350.00 | 按需 | 强烈建议 | 京东 | https://item.jd.com/11990835108.html | ¥0.00 | 下单前在选项中确认电流规格满足至少3A；必须支持限流 | 已有带限流电源可不买
调试工具 | 优利德 UT890D+ 数字万用表 | 真有效值，直流电流档、通断档 | 1 | 台 | ¥229.00 | 按需 | 强烈建议 | 京东 | https://item.jd.com/100164052612.html | ¥0.00 | 测堵转电流前核对表笔插孔、保险丝及电流量程 | 已有可靠万用表可不买
焊接工具 | 得力 DL-HT936 60W 控温焊台 | 60W旋钮调温，936型 | 1 | 台 | ¥169.00 | 按需 | PCB阶段必需 | 京东 | https://item.jd.com/100057797828.html | ¥0.00 | 焊电机抗干扰电容和后续PCB会用到；注意通风 | 已有恒温焊台可不买
当前必买预算合计（不含“按需”和“否”） |  |  |  |  |  |  |  |  |  | ¥347.70 | 实际支出请将是否计入预算改为“是”并更新单价

Sheet: 选型与采购说明
选型、下单与验收说明
主题 | 建议 | 原因/风险
采购顺序 | 先买开发板、驱动模块、电机/轮胎/支架、供电、摇杆和原型连接材料。 | 电机参数和机械尺寸会决定驱动器及PCB设计。
电机选择 | 首版直接选择“2WD迷你全套”底盘套件及其配套TT电机。 | 套件可避免电机轴、轮毂、支架和底盘孔位不匹配；到货后仍需实测电流。
传动匹配 | 不要再单独购买本表之外的N20电机、轮胎和支架。 | 先用配套TT电机跑通原型，V2再根据速度和扭矩需求升级。
供电安全 | 车体先用4节AA镍氢；禁止USB 5V与电池直接并联。 | 电机启动压降可能导致ESP32复位，后续PCB需分支滤波。
TB6612适用条件 | 只有在单电机实测堵转电流接近或低于1A时继续使用。 | 超过能力会导致芯片过热、限流或损坏，应更换更强驱动。
电商链接 | 清单已改为具体商品详情页；必须按照“下单时选择的具体规格”选择SKU。 | 同一详情页通常包含多个型号，直接打开链接不代表默认选项就是目标规格。
预算使用 | “是否计入当前预算”可改为是/按需/否；小计和总览会自动更新。 | 已有工具可标记为否，实际单价可直接覆盖参考单价。
到货验收 | 核对型号数量；万用表测短路；开发板先跑LED；电机逐个限流测试并记录。 | 不要把所有器件一次接上电，便于隔离故障。
价格声明 | 参考价为2026-08-02常见零售预算值，不代表指定商家承诺价，且未计运费。 | 促销、地区、店铺、包装数量和开票要求都会改变价格。
