LiWenhui2/RC-Car/outputs/rc_car_bom_20260802/RC-CAR-V1.0_器件采购清单_真实核价修正版.xlsx

Sheet: 采购总览
RC-CAR-V1.0 真实核价总览
指标 | 结果 | 本次纠正的关键项目
已核实并计入预算 | ¥39.03 | 项目 | 原清单 | 本次核对 | 处理 | 说明
完整核实条目数 | 2 | ESP32-C3 | ¥78.00 | ¥13.10 | 已替换 | DZQJ 已焊接版；2块 ¥26.20，页面标注包邮
待补价格/运费条目数 | 8 | 2WD底盘 | ¥59.00 | ¥12.83 | 已更正 | 已切换到“2WD迷你全套”对应SKU
链接失效/待重新选品 | 2 | USB数据线 | ¥39.90 | ¥83.00 | 不计预算 | 页面为2个装，运费未显示
清单总条目数 | 12 | 其他未核价项 | 使用估价 | 价格留空 | 不计预算 | 看不到实价就不写入总额
核价日期 | 2026-08-02

Sheet: 器件清单
RC-CAR-V1.0 器件采购清单（页面实价核对版，2026-08-02）
规则：页面价、规格和运费均能确认时才计入预算；未核实项目不再用“同类市场价”代替。最终价格仍以提交订单页面为准。
类别 | 商品/方案 | 下单规格 | 数量 | 单位 | 页面单价(元) | 基础运费(元) | 核价状态 | 计入当前预算 | 平台 | 商品详情直达链接 | 到手小计(元) | 核价依据 | 风险与备注
原型电子 | DZQJ ESP32-C3 SuperMini 开发板 | 已焊接排针 | 2 | 块 | ¥13.10 | ¥0.00 | 已核实 | 是 | 京东 | https://ic-item.jd.com/10120505745601.html | ¥26.20 | 页面常规价 ¥13.10；河南地区有货（库存10000+）；包邮（以订单为准） | 采用常规价计预算，不依赖企业会员价 ¥12.71 或临时补贴
原型电子 | TB6612FNG 双路电机驱动模块 | 焊接排针、3.3V逻辑兼容 | 1 | 块 |  |  | 价格未显示 | 否 | 京东 | https://ic-item.jd.com/10162327051022.html |  | 页面标题匹配，但本次未读取到有效价格 | 原先 ¥29 为同类估价，已删除；看到实际价后再填
机械动力 | 登仕唐 2WD 智能小车底盘套件 | 2WD迷你全套 | 1 | 套 | ¥12.83 | ¥0.00 | 已核实 | 是 | 京东 | https://ic-item.jd.com/10095736668346.html | ¥12.83 | 切换到“2WD迷你全套”后显示 ¥12.83；页面标注包邮（以订单为准） | 到货核对是否含2个TT电机、2个轮胎、万向轮、电池盒与安装件
遥控输入 | 登仕唐 PS2 双轴摇杆模块 | 红板防反插接口，配5P线 | 1 | 个 |  |  | 价格未显示 | 否 | 京东 | https://ic-item.jd.com/10207428429840.html |  | 页面标题和规格匹配，但价格栏为空 | 原先 ¥18 为估价，已删除
原型连接 | DZQJ MB-102 面包板基础实验套件 | 830孔面包板、杜邦线及常用原型配件 | 1 | 套 |  |  | 链接失效 | 否 | 京东 | https://item.jd.com/10145422358367.html |  | 打开后回到京东通用页，无法确认商品与价格 | 不要按原链接下单，需重新选品
调试连接 | 绿联 30875 二合一数据线（2个装） | USB-A转Micro USB + Type-C，1m，2个装 | 1 | 套 | ¥83.00 |  | 已核单价/待核运费 | 否 | 京东 | https://item.jd.com/100061434896.html |  | 页面显示 ¥83.00；本次未读取到运费 | 若已有可传数据的USB-C线，可不买
供电 | 4×AA 镍氢电池与电池盒 | 同品牌同容量，4节；另配4节电池盒 | 1 | 组 |  |  | 待重新选品 | 否 | — |  |  | 原链接实际落在7号电池选项，不能作为AA方案报价 | 这是车体必需项，但没有可靠直达商品前不写价格
供电 | 松下 AAA 7号碱性电池4节 | 7号4节（仅用于原型短测） | 1 | 组 | ¥22.13 |  | 已核单价/待核运费 | 否 | 京东 | https://item.jd.com/10141652671465.html |  | 当前页面标题与价格为“7号4节”，¥22.13 | 正式方案应换4节AAA镍氢充电电池，并另配4节电池盒
抗干扰 | 104 100nF 50V 陶瓷电容100只 | 100nF/0.1µF，50V，引脚间距约5mm | 1 | 包 |  |  | 价格未核实 | 否 | AliExpress | https://www.aliexpress.com/item/32375639403.html |  | 本次未取得稳定的人民币到手价 | 每台电机两端焊1只；不要使用原先 ¥15 估价
调试工具 | 兆信 KXB-325DW 可调直流稳压电源 | 标配+输出线，需支持恒流限流 | 1 | 台 | ¥389.00 |  | 已核单价/待核运费 | 按需 | 京东 | https://item.jd.com/11990835108.html |  | 页面显示 ¥389.00；本次未读取到运费 | 已有可靠限流电源可不买
调试工具 | 优利德 UT890D+ 数字万用表 | 真有效值、直流电流档、通断档 | 1 | 台 | ¥127.00 |  | 已核单价/待核运费 | 按需 | 京东 | https://item.jd.com/100164052612.html |  | 页面显示 ¥127.00；本次未读取到运费 | 已有可靠万用表可不买
焊接工具 | 得力 DL-HT936 60W 控温焊台 | 60W旋钮调温，936型 | 1 | 台 |  |  | 价格未显示 | 按需 | 京东 | https://item.jd.com/100057797828.html |  | 页面标题匹配，但本次未读取到有效价格 | 原先 ¥169 为估价，已删除
当前已完整核实并计入预算的到手合计 |  |  |  |  |  |  |  |  |  |  | ¥39.03 | 未核实项目必须补齐页面价和运费后，才能加入最终采购总额。

Sheet: 核价说明
核价口径与下单规则
主题 | 规则 | 原因
页面单价 | 只写本次在商品详情页直接看到的所选规格价格 | 避免把市场估价误认为指定商品价格
基础运费 | 只有页面明确包邮或满足免邮门槛时才写0；未显示则留空 | 地区、会员、店铺和订单金额都会影响运费
到手小计 | 仅“已核实”且“计入当前预算=是”时自动计算 | 价格或运费缺一项时不制造虚假的精确总价
SKU | 同一详情页切换规格后，记录切换后的具体SKU链接 | 详情页默认选项可能与清单要求不同
价格有效期 | 本次核价日期为 2026-08-02 | 电商价格和库存会变化，下单前需在结算页复核
当前预算 | ¥39.03 只覆盖两块ESP32-C3与一套2WD迷你全套 | 它不是完整可开工预算；其余必需项尚待完成核价
