LiWenhui2/RC-Car/outputs/cadence_library_bom_20260919/preview_PCB建库BOM.png

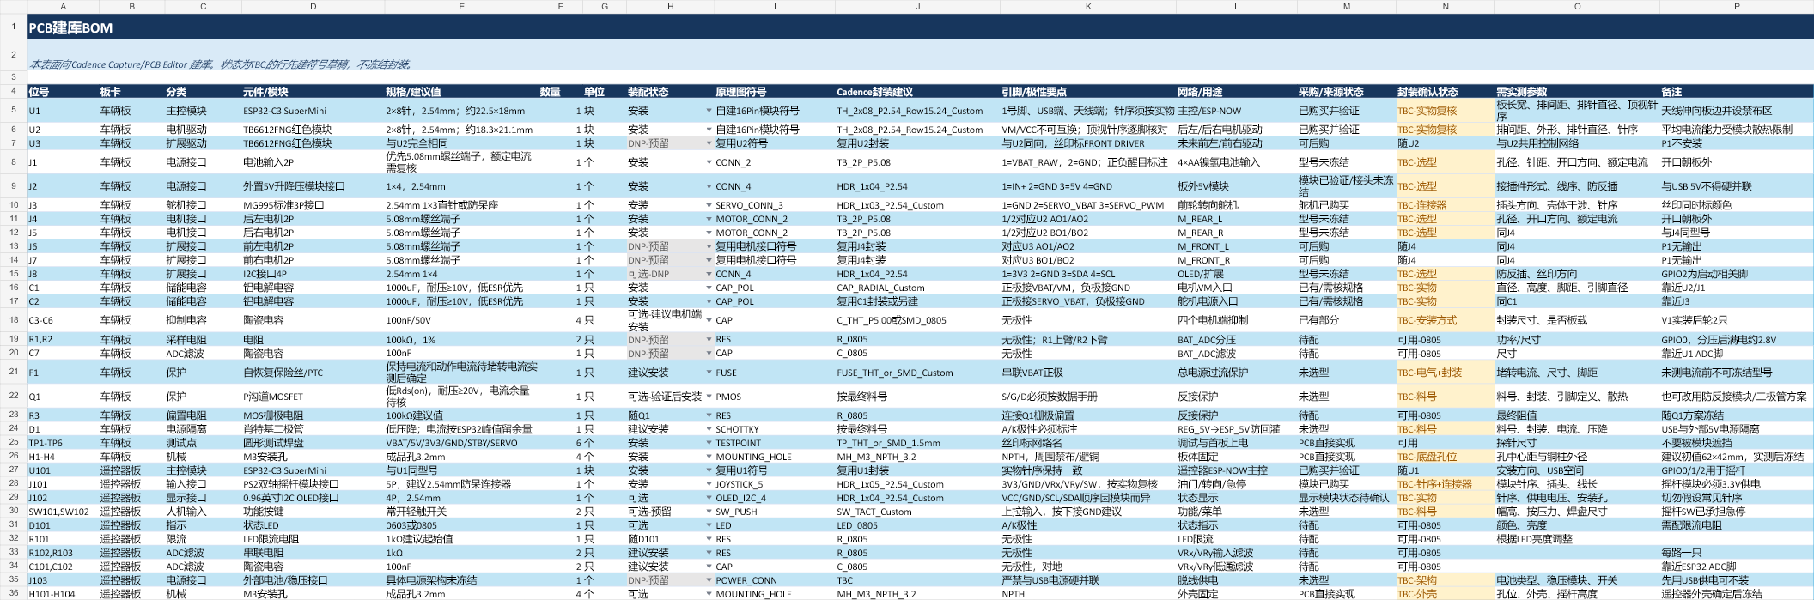
outputs/cadence_library_bom_20260919/preview_PCB建库BOM.png
