LiWenhui2/RC-Car/outputs/cadence_library_bom_20260919/preview_使用说明.png

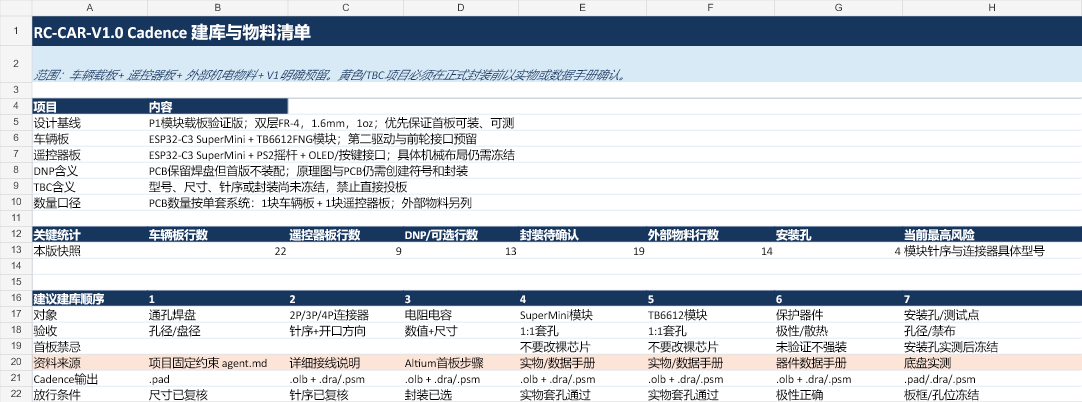
outputs/cadence_library_bom_20260919/preview_使用说明.png
