LiWenhui2/RC-Car/outputs/cadence_library_bom_20260919/preview_外部机电物料.png

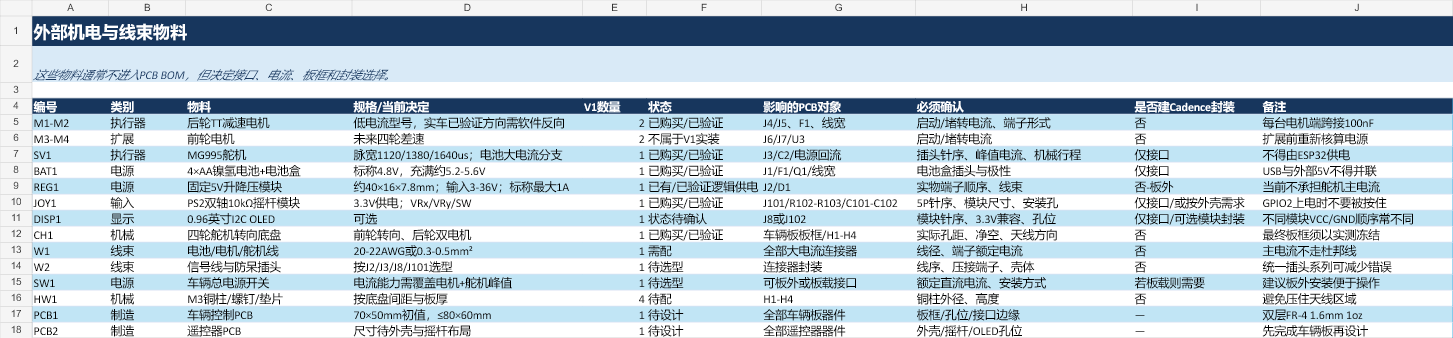
outputs/cadence_library_bom_20260919/preview_外部机电物料.png
