LiWenhui2/RC-Car/outputs/cadence_library_bom_20260919/preview_封装制作清单.png

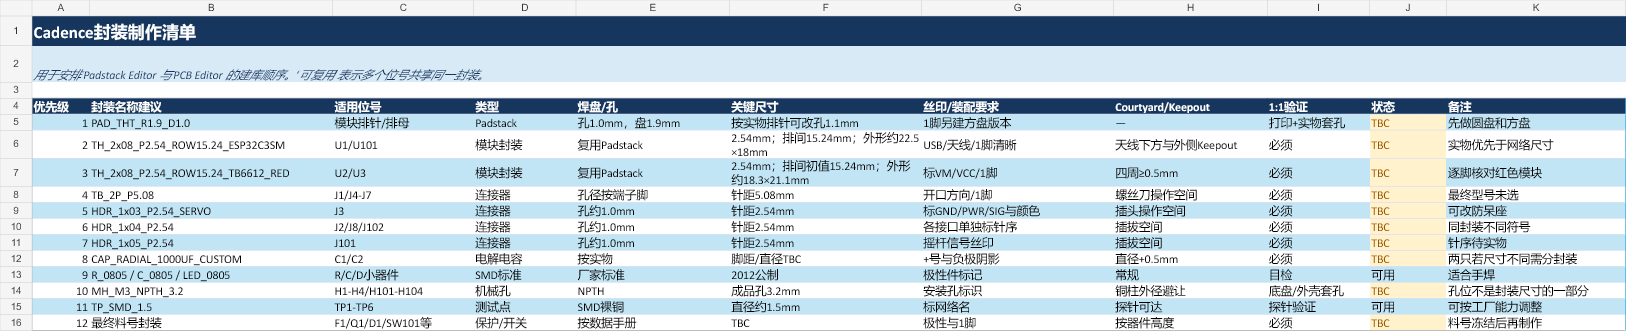
outputs/cadence_library_bom_20260919/preview_封装制作清单.png
