LiWenhui2/RC-Car/outputs/cadence_library_bom_20260919/preview_封装前待确认.png

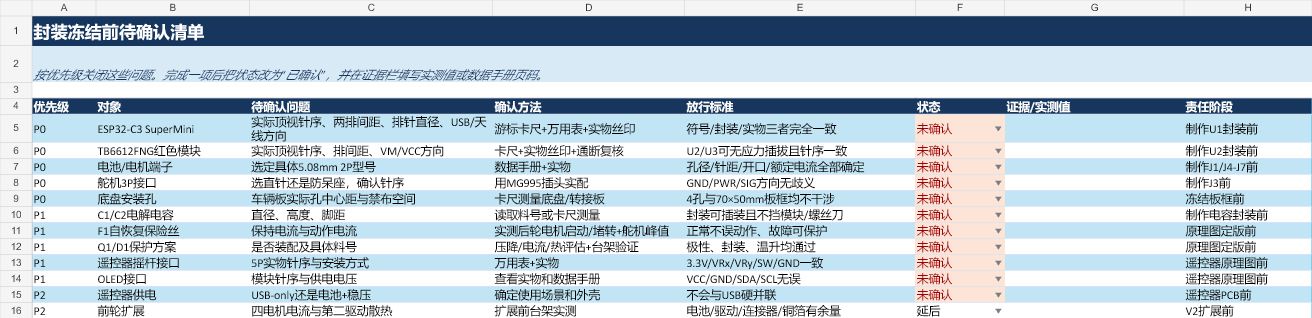
outputs/cadence_library_bom_20260919/preview_封装前待确认.png
