LiWenhui2/RC-Car/outputs/cadence_library_bom_20260919/preview_模块针序与网络.png

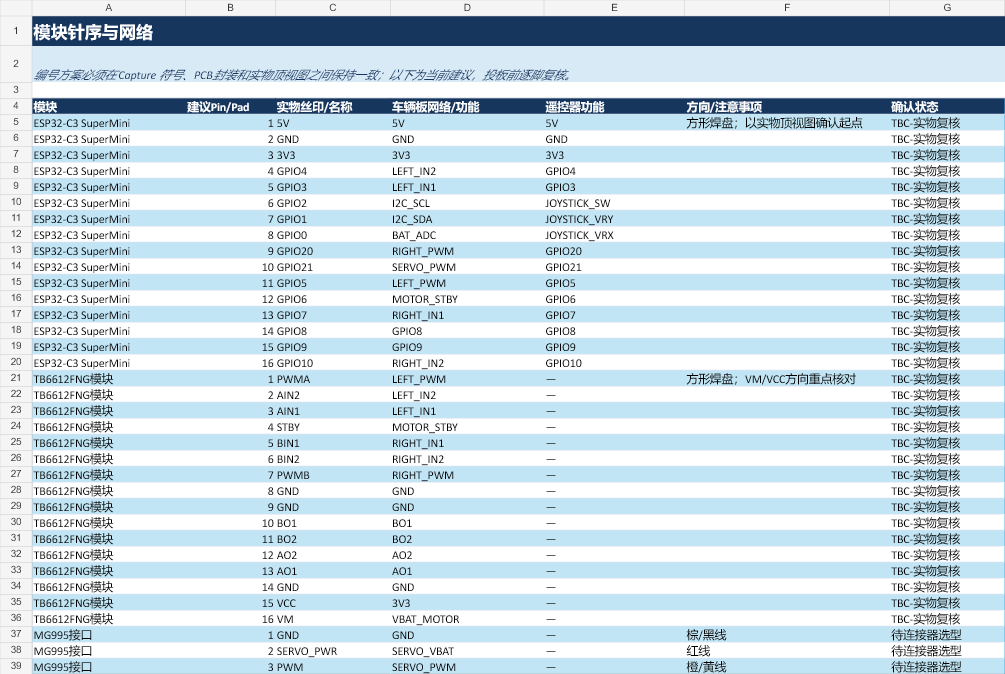
outputs/cadence_library_bom_20260919/preview_模块针序与网络.png
