LiWenhui2/RC-Car/outputs/cadence_library_bom_20260919/preview_资料来源.png

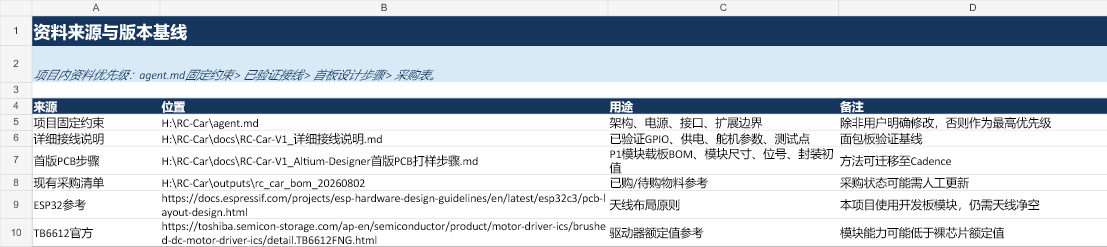
outputs/cadence_library_bom_20260919/preview_资料来源.png
