LiWenhui2/RC-Car/outputs/rc_car_bom_20260802/previews/器件清单.png

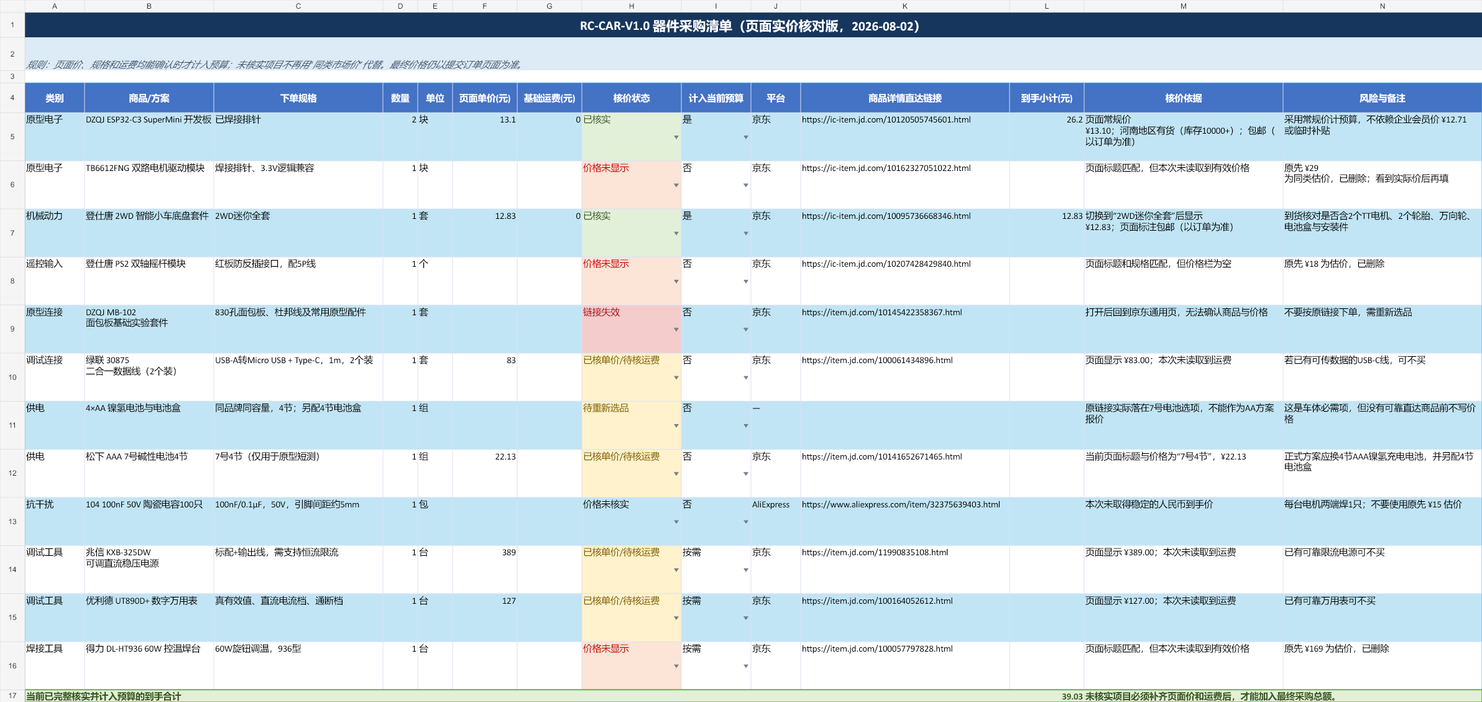
outputs/rc_car_bom_20260802/previews/器件清单.png
