LiWenhui2/RC-Car/outputs/rc_car_bom_20260802/previews/选型与采购说明.png

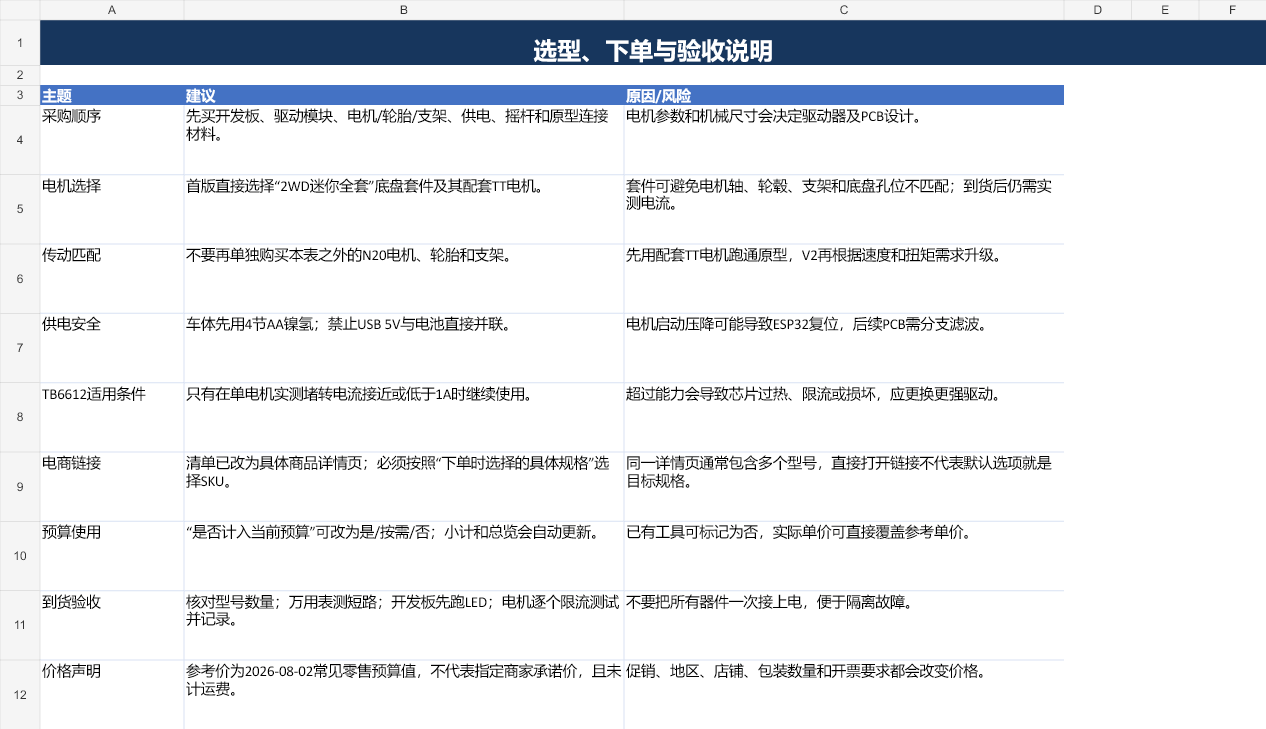
outputs/rc_car_bom_20260802/previews/选型与采购说明.png
