LiWenhui2/RC-Car/outputs/rc_car_bom_20260802/previews/采购总览.png

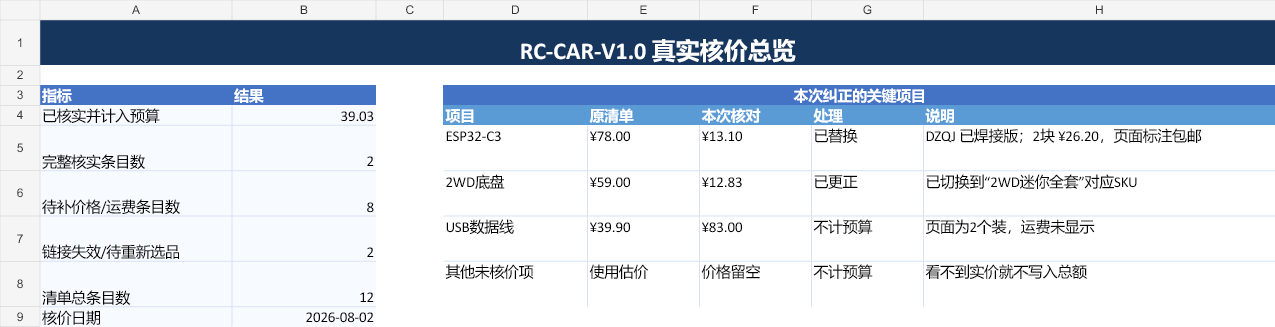
outputs/rc_car_bom_20260802/previews/采购总览.png
