LiWenhui2/RC-Car/manufacturing/gerber/README.md

# Gerber 文件

存放 PCB 铜层、阻焊、丝印、钢网和板框等 Gerber 生产文件。发送给板厂前应使用独立 Gerber Viewer 检查。
