LiWenhui2/RC-Car/manufacturing/assembly/README.md

# 装配文件

存放元器件坐标文件、装配图、贴片图、位号图和装配说明。坐标文件输出后应检查板面、旋转角度和单位。
