LiWenhui2/RC-Car/manufacturing/drill/README.md

# 钻孔文件

存放 Excellon 钻孔文件及钻孔表。需要区分电镀孔、非电镀孔、圆孔和槽孔，并确认单位及坐标格式。
