LiWenhui2/RC-Car/test-records/README.md

# RC-CAR 测试与放行记录

本目录保存项目各阶段的测量值、检查结果、问题记录和放行结论。

## 记录规则

- 每项记录必须写明日期、执行人、工具或量具。
- 实测值不得只写“正常”，应记录电压、电流、尺寸或观察结果。
- 未完成项保持为 `[ ]`；确认完成后改为 `[x]`，并补充证据或文件位置。
- 阶段放行前，必须关闭所有 P0 问题；无法关闭的问题要写明风险和处理决定。
- 照片、截图和仪表读数文件建议使用 `YYYYMMDD_对象_项目` 命名。

首份记录见 `stage-00-engineering-setup.md`。
