LiWenhui2/RC-Car/docs/diagrams/fc7eef8d-85cc-4f3e-8b4f-e42f0ff5232b.pdf

11

22

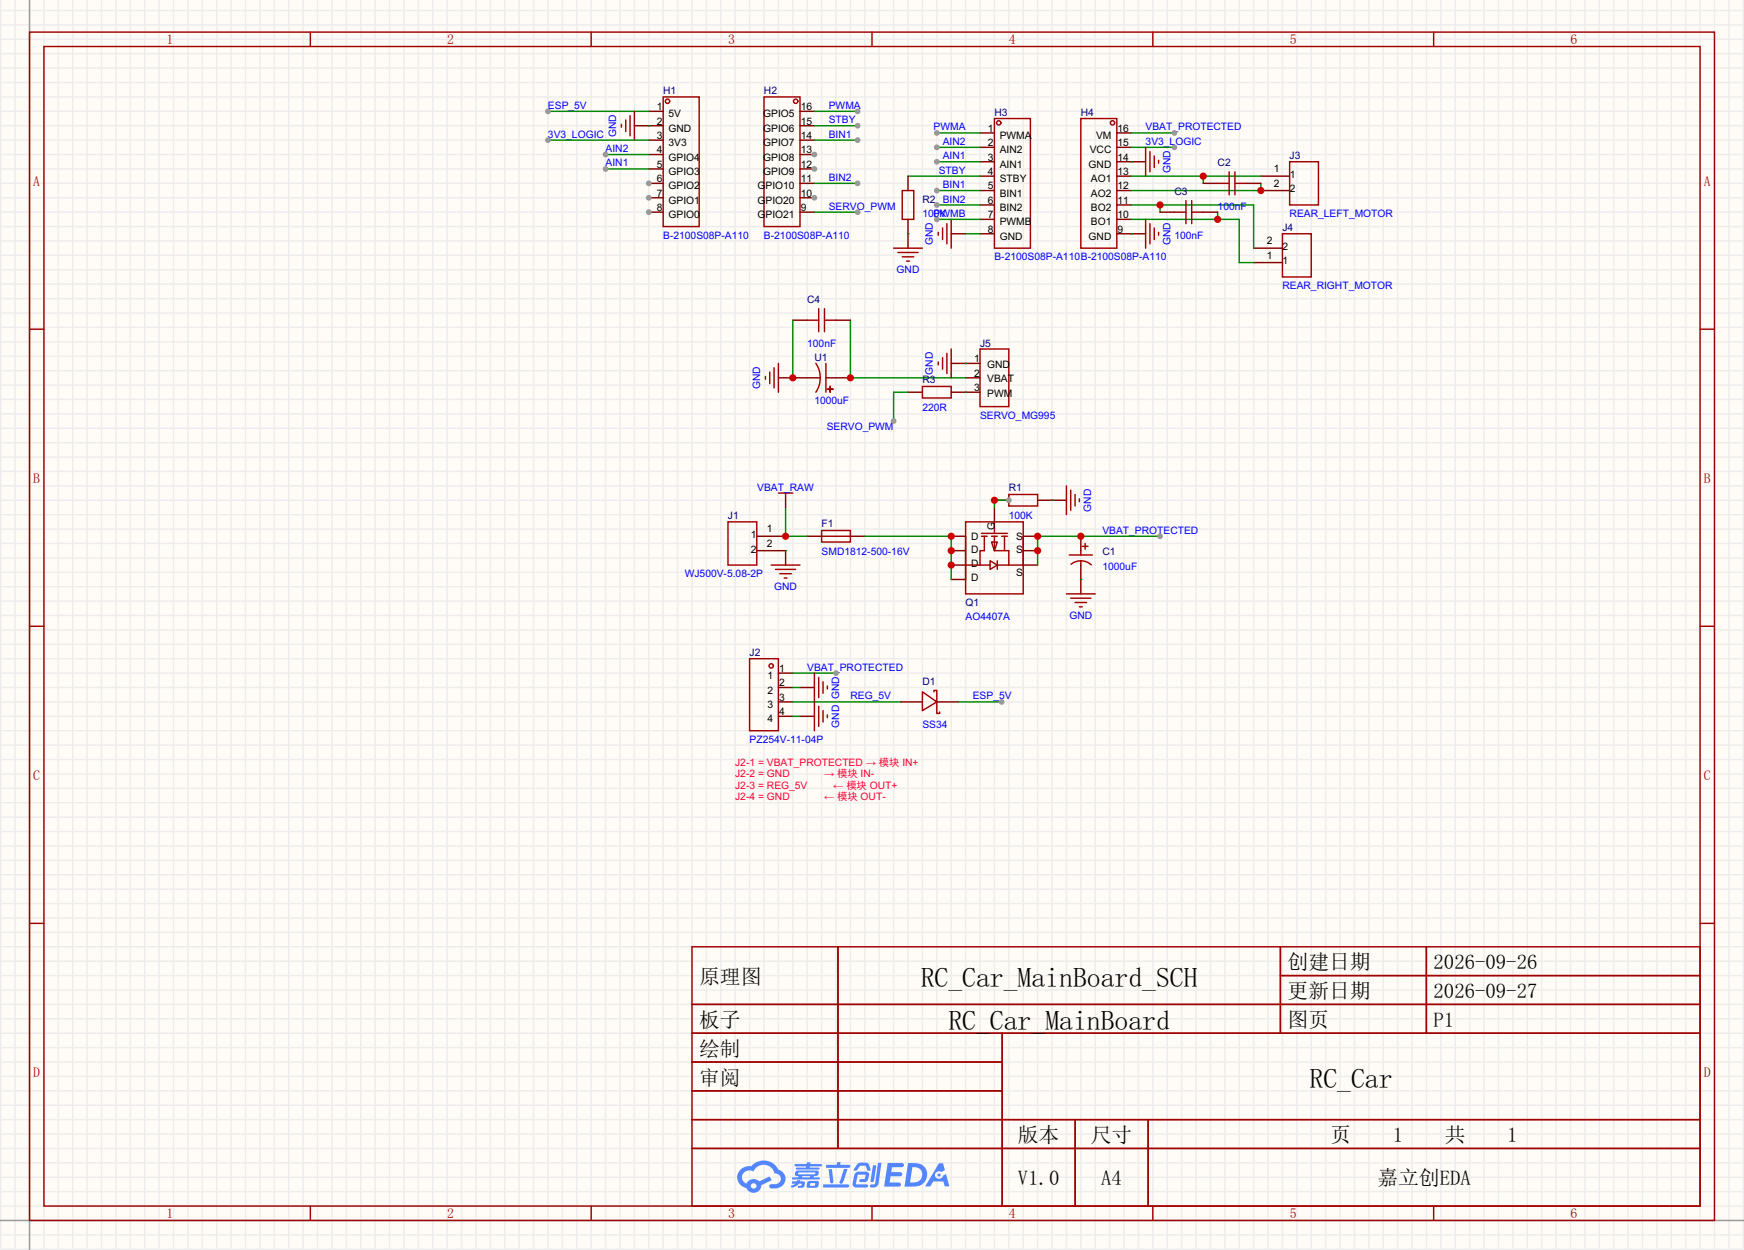
[picture p60: page 1]

ESP_5V | 1 | 5V | GPIO5 16 | PWMA | | | H3 | H4

2 | | GPIO6 15 | STBY | PWMA | | | | | | VBAT_PROTECTED

3V3_LOGIC | 3 | GND | GPIO7 14 | BIN1 | | 1 | PWMA | | VM | 16

AIN2

4 | 3V3 | | GPIO8 13 | | | | AIN1 AIN2 | 2 | AIN2 | VCC | 15 | | | | J3
AIN1 | 5 | GPIO4 | | GPIO9 12 | | | | | 3 | AIN1 | GND | 14 | | C2 | 1

A | | 6 | GPIO3 GPIO2 | GPIO10 11 | | | BIN2 | | STBY | 4 | STBY | AO1 | 13 | | | 2 | | A

8 | GPIO1 | | | 9 | SERVO_PWM | 100K | | 6 | BIN2 | BO2 | 11 | | 100nF | | REAR_RIGHT_MOTOR 1 REAR_LEFT_MOTOR
7 | | GPIO20 10 | | | | R2 | | | BIN1 | AO2 | 12 | C3 | | | 2

BIN1 | 5
BIN2
PWMB

GPIO0 | GPIO21 | | 7 | PWMB | BO1 | 10 | | J4
B-2100S08P-A110 | | B-2100S08P-A110 | 8 | GND | GND | 9 | 100nF | 2

GND | 1

100nF | | | J5
U1

1 | GND

R3 | 2 | VBAT

1000uF | | 3 | PWM

220R | SERVO_MG995

SERVO_PWM

WJ500V-5.08-2P | VBAT_RAW 1 | 1 2 2 3 3 4 4 | | | | | 1000uF

J1 | 100K
1 | 2 | | S | VBAT_PROTECTED
2 | | SMD1812-500-16V | DDD D | SS | C1

VBAT_PROTECTED GND | | D1

REG_5V | | ESP_5V

J 2 - | 3 = | R | E G | _ 5 V | | | ← | 模 块 | O | U T | +
J 2 - | 4 = | G | N D | | | ← | 模 | 块 | O U | T -

更新日期 | | 2026-09-27

板子 | RC_Car_MainBoard | 图页 | | P1
绘制

D | 审阅 | | | RC_Car | | D
