LiWenhui2/RC-Car/(list of files, drawings)

Other design files:
AD/RC-Car/RC-Car.PrjPcb
AD/RC-Car/RC-Car.SchDoc
AD/RC-Car/RC-Car_Components.SchLib
